Monitoramento-do-Ar-PI2/zefiro-electronics/README.md

# Zefiro electronics
This is the electronic team repository, here you can find the development of embedded system codes, eletronic schematics and pcb layouts.
