Monitoramento-do-Ar-PI2/zefiro-electronics/AnalogElectronics/README.md

<h1 align="center">
      Eletrônica Analógica Zéfiro
</h1>

<p align="justify">
      A eletrônica analógica é aplicada na estação de monitoramento de ar Zéfiro, sendo um sistema de instrumentação eletrônica modular, onde seus componentes são distríbuidos no melhor posicionamento para seu uso e as ligações realizadas, por meio de cabos, com a central de controle, utilizando o microcontrolador ESP32.
  
 <p align="center">
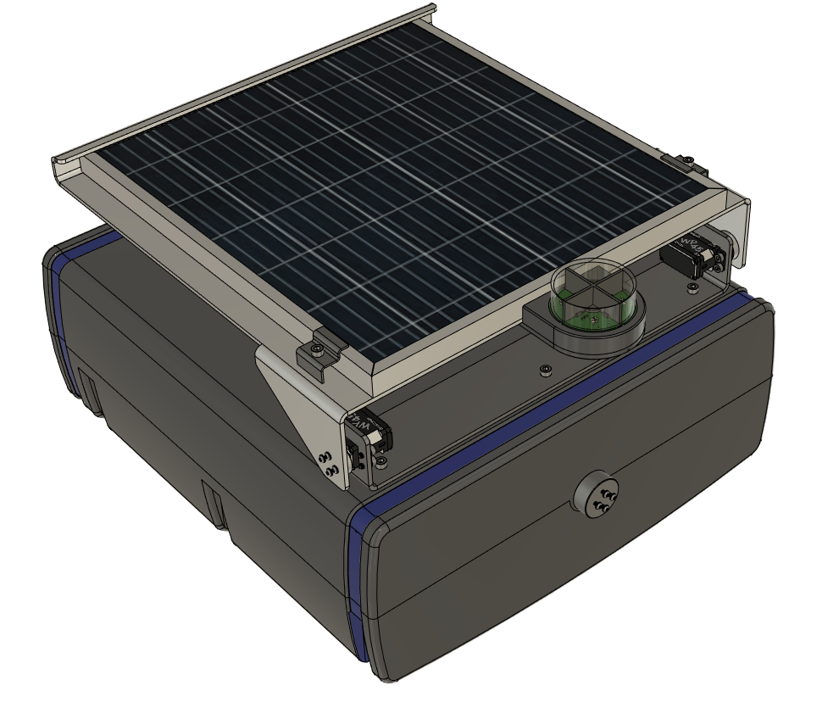
[picture p8: AnalogElectronics/RR_01.png]
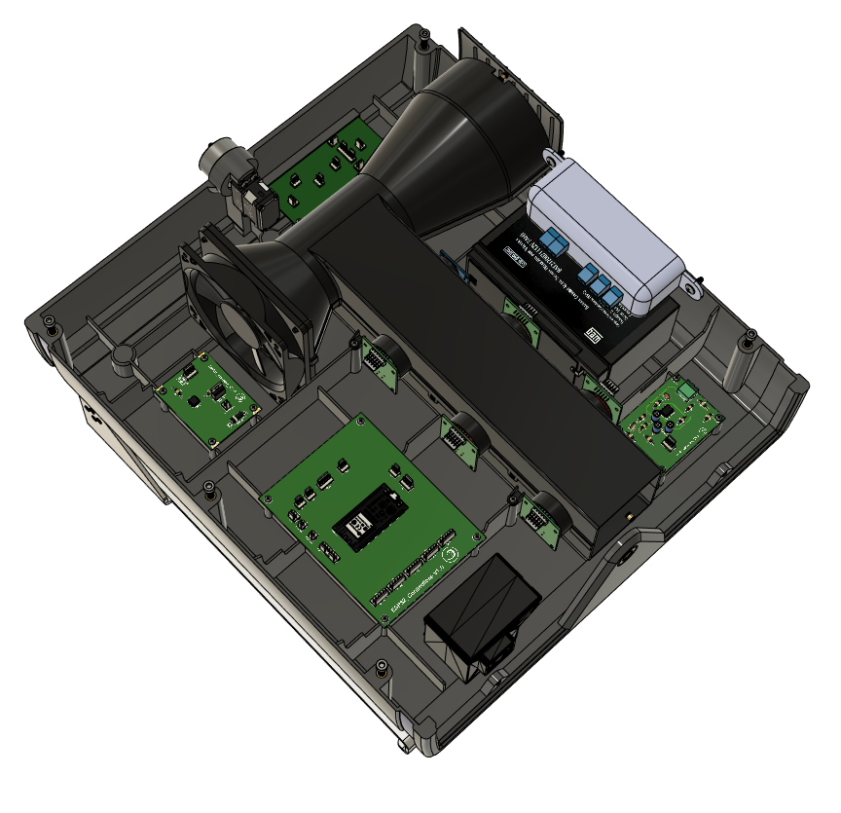
[picture p9: AnalogElectronics/RR_02.png]
        
</p>

 - **Esquemático Geral** O esquemático geral representa todos os módulos e suas conexões entre si, enquanto cada pasta tem o desenvolvimento individual do esqumático e layout de pcb destes módulos.

<p align="center">
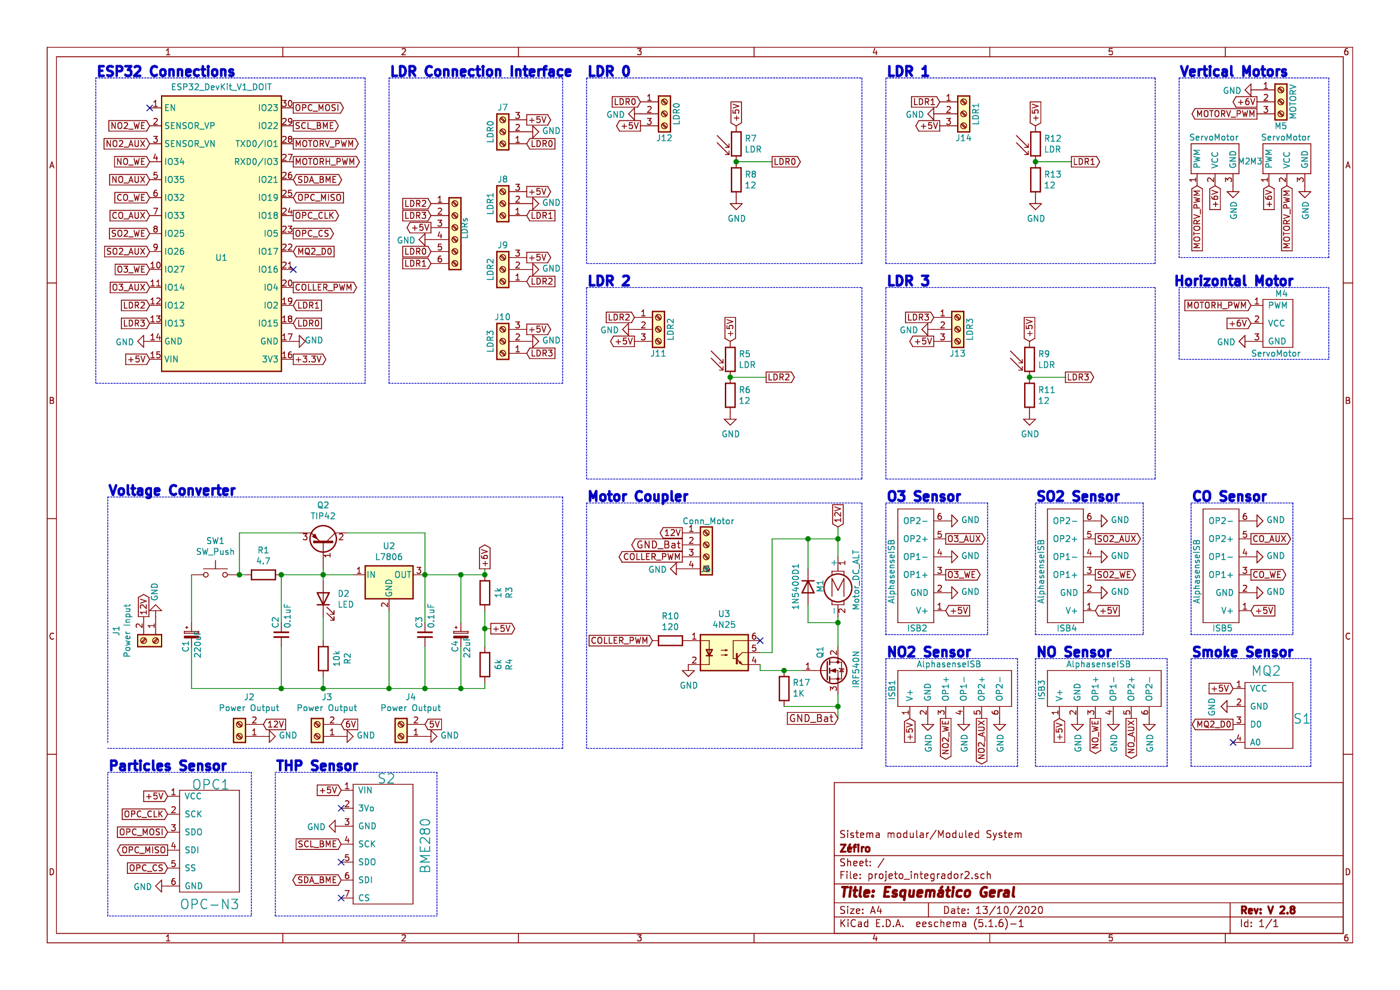
[picture p10: AnalogElectronics/esq_geral.png]
      
</p>

  #### Desenvolvedores:
  Clara Justa
  
  Débora Janini
  
  Felipe Alcântara
