Monitoramento-do-Ar-PI2/zefiro-electronics/EmbeddedSystem/README.md

<h1 align="center">
      Sistema Embarcado Zéfiro
</h1>

<p align="justify">
      O sistema embarcado do Zéfiro, tem como função o controle da estação autônoma e a transmissão dos dados coletados para o servidor. O sistema embarcado foi desenvolvido no modelo máquina de estados, abaixo é possível verificar o diagrama da máquina de estados desenvolvido.

 <p align="center">
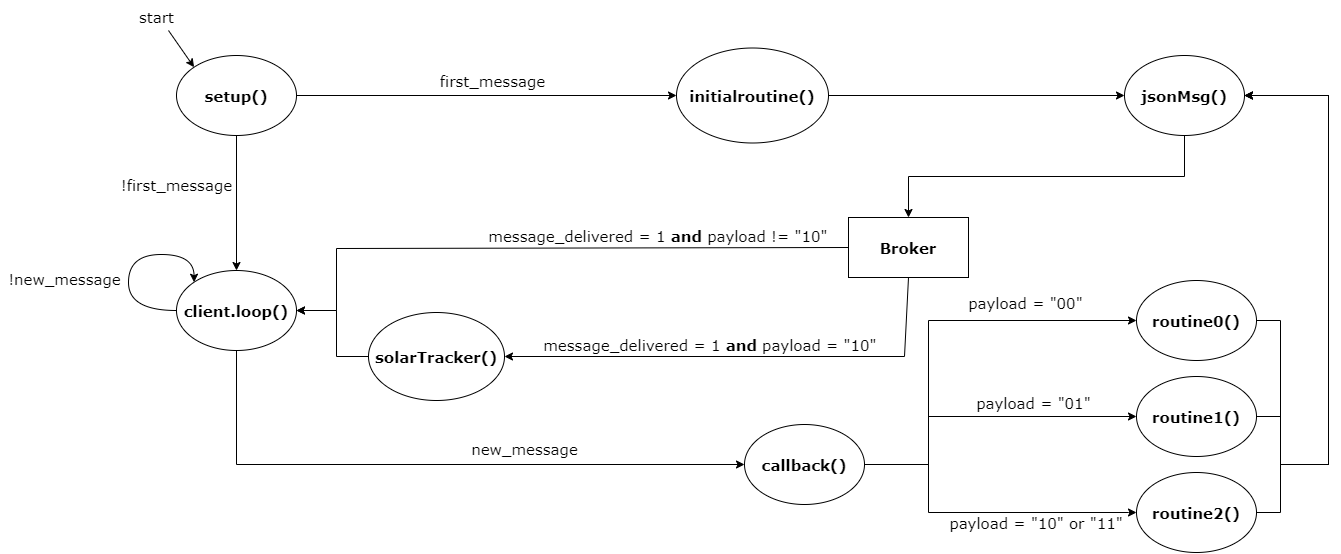
[picture p11: EmbeddedSystem/me_zefiro.png]
      
</p>      

Na pasta "Basics" é encotrado os códigos para teste dos subsistemas separados e a pasta "Integration" tem o desenvolvimento da integração do sistema no formato da imagem acima.
