Monitoramento-do-Ar-PI2/zefiro-electronics/EmbeddedSystem/Basics/README.md

## Desenvolvimento e teste de subsistemas
