Monitoramento-do-Ar-PI2/zefiro-electronics/AnalogElectronics/Dimensionamento_Solar.part2.pdf

1-Diagrama Unifilar

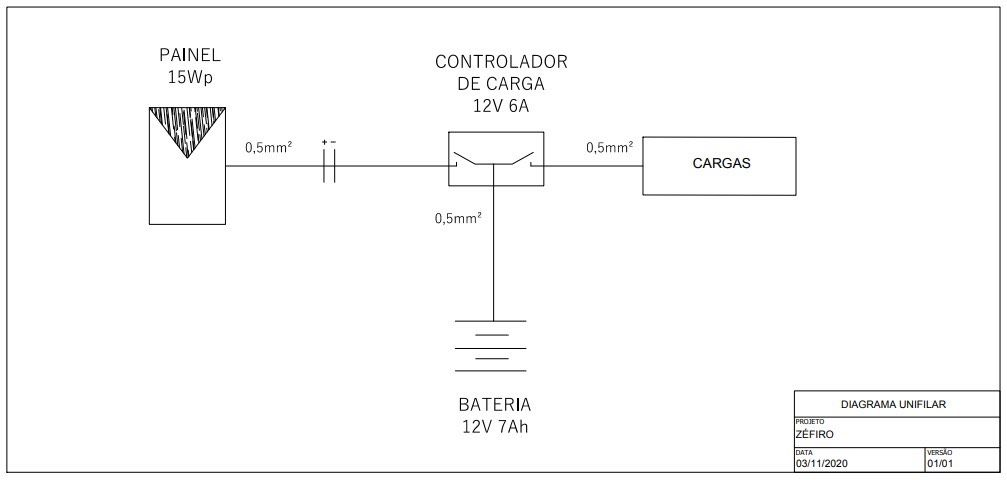
[picture p12: figure]

Figura: Diagrama Unifilar em AutoCad

2-Dimensionamento dos Fios
O dimensionamento dos cabos fotovoltaicos é realizado observando-se sempre critérios de Normas Brasileiras Regulamentadoras a respeito do funcionamento de placas fotovoltaicas. O primeiro cálculo realizado objetiva conhecer o valor da bitola do cabo e é definido da seguinte maneira:

S = N * Isc

S: Seção do cabo fotovoltaico N: Número de strings
Isc: Corrente de curto-circuito

S= 1 *0,93 = 0,93 A

Segundo a NBR 70 C (figura abaixo):

Fonte: ABNT

A seção do cabo escolhida é de S= 0,5mm².

Para finalizar os cálculos de dimensionamento dos cabos fotovoltaicos, necessita-se saber qual a queda de tensão máxima permitida aplicada à este projeto. Segundo a NBR 5410:

“Limites de queda de tensão fixados pela NBR 5410: 4% para as instalações alimentadas diretamente pela rede de distribuição pública de baixa tensão; e 7% para as instalações que contam com subestação própria ou com geração própria. Além disso, a queda de tensão máxima admissível nos circuitos terminais é de 4%.

Considerando a NBR acima, abaixo seguem os cálculos para descobrir a máxima queda de tensão permitida no presente projeto:

Vmp= Tensão máxima permitida = 17,5V
4% de 17,5V = 0,7V
Máxima tensão de queda permitida = 16,8V

3-SEGUIDOR SOLAR

Os seguidores solares são os únicos capazes de acompanhar o movimento do sol, a partir de um único ponto de referência ou a partir de dois pontos de referência. O seguidor solar de um eixo segue apenas o movimento do sol, enquanto o seguidor duplo se movimenta de leste para oeste e de norte a sul.
Medeiros (2016) descreve os tipos de rastreadores solar de dois eixos com ajuste de inclinação sendo:
- Rastreador de eixo vertical: eixo de norte-sul com o eixo do zênite, conhecido como rastreador de azimute do sol;
- Rastreador de eixo horizontal: orientado em paralelo à superfície da terra, pode ser orientado de leste-oeste ou norte-sul;
- Rastreador azimute-elevação: tem dois eixos de movimento, podendo gerar um melhor rendimento na captação de radiação solar, porém é necessário correção angular a partir do ângulo de azimute (Z) e o ângulo de elevação (H).

O sistema de dimensionamento do Zéfiro será feito com um rastreador azimute/elevação,figura 1, onde o sistema se movimenta a partir do eixo de rotação e translação, tendo o sol como referência , o fuso horário e dia no ano local(SANTOS,
C. A. S; SILVA, H. A. A; CARVALHO, J. L,2015).

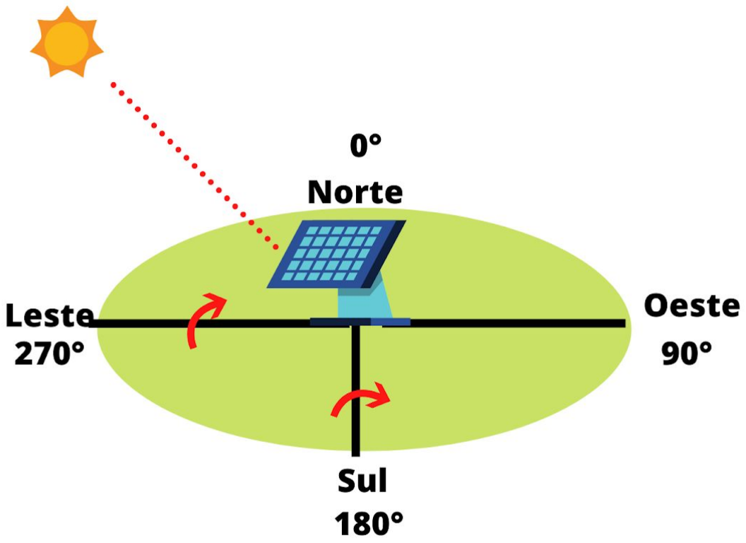
[picture p13: figure]

Figura 1: Modelo Rastreado Azimute-Elevação Fonte: Própria Autoria

A partir do Local Standard Time Meridian (LSTM) é feita a compensação do fuso local pela equação 1:
LSTM = 15ºΔT GMT

(1)

Onde, ΔT GM é a diferença entre o fuso horário local com relação ao fuso T horário do meridiano de Greenwich. Outro ponto que deve ser considerado é a trajetória do sol (EoT) que tem como finalidade corrigir a excentricidade da órbita terrestre.
EoT = 9, 37 sen(2B) − 7, 53 cos(B) − 1, 5 sen(B) (2)
B= | (d | 1) , d é o número de dias do ano; 365
360 | − 8

A partir da compensação do fuso local e a longitude do ambiente é possível obter o fator de correção,

TC = 4 ( Longitude − LSTM) + EoT (3)

O horário solar local (LST) é obtido a partir do horário local (LT) definido e do fator de correção

LST = LT + TC (4)
Para converter os dados obtidos em valor angular é necessário passar todos os dados em horário angular (HRA):
HRA = 15º (LST − 12) (5)

Com os dados em valor angular é possível obter o ângulo de declinação, que varia a cada estação do ano, ou seja, quando se inicia uma nova estação a incidência dos raios solares da Terra mudam, com isso nos período de equinócio o ângulo de declinação é considerado igual a 0º, enquanto para os períodos de solstício o ângulo deve ser calculado conforme a equação 6, onde d é o número de dias do ano e 23,45° é utilizado para os meses de solstícios que é de junho a dezembro.

δ = sen (sen(α)sen(( )(d 1)))

−1
365
360 | − 8 | (6)

Onde α = 0° ou 23, 45°
A partir do ângulo de elevação (H) é possível calcular a altura da placa solar, equação 7, e o azimute solar de rotação (Z),equação 8, ou seja, para cada hora do dia o azimute/elevação muda de acordo com os ângulos obtidos pela equação 7 e 8:
H = sen [senδsenφ | osδcosφcos(HRA)]
−1 | + c | (7)
Z = cos [(senδcosθ | osδsenθcos( HRA) ) ]
−1 | − c | (8)

Para analisar o comportamento da placa solar a partir das equações utilizadas que determinam seu grau de deslocamento, se escolheu o dia 22/10/2020 para, primeiramente realizar o cálculo de forma analítica,os resultados obtidos podem ser vistos na tabela 2.

Tabela 2- Resultados obtidos de forma analítico para o dia 22/10/2020

Fonte: Própria autoria

A partir da tabela 2 foi possível compreender o sistema de mecanismo de funcionamento de movimentação da placa solar para um dia, sendo assim se criou um modelo no excel, figura 2, para observar o comportamento da mudança do azimute/elevação para cada dia do ano, pois para cada dia do ano o ângulo de incidência muda, além do mais de janeiro a maio o ângulo α do ângulo de declinação é igual a 0°, enquanto de junho a dezembro o α é igual a 23,45°, interferindo na posição de elevação e de rotação dos eixos da placa solar.

HORÁRIO | AZIMUTE(Z) | ALTURA(H)
06h00 | 113° | 45°
07h00 | 115,21° | 56°
08h00 | 116° | 67°
09h00 | 117° | 68°
10h00 | 116° | 60°
11h00 | 113° | 48°
12h00 | 110° | 34°
13h00 | 106° | 20°
14h00 | 103° | 6°
15h00 | 99° | -7°
16h00 | 95° | -22°
17h00 | 91° | -37°
18h00 | 88° | -54°

Figura 2- Modelo Matemático das Equações de Azimute-Elevação em Excel para os 365 dias do ano

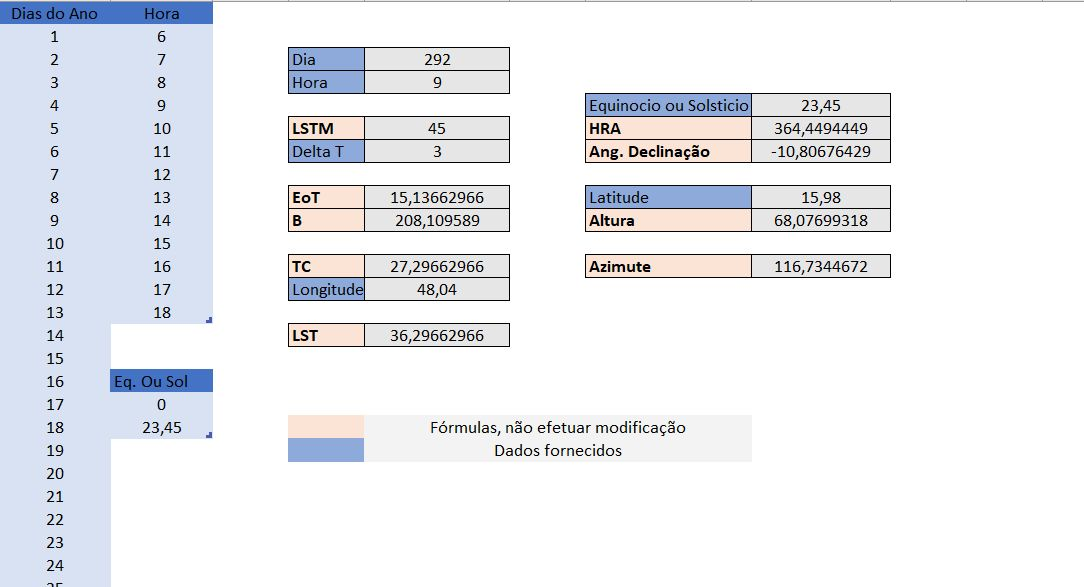
[picture p14: figure]

Fonte: Autoria Própria

4- Referência Bibliográfica
SANTOS, C. A. S; SILVA, H. A. A; CARVALHO, J. L. Desenvolvimento de um Mecanismo de Posicionamento de Placas Fotovoltaicas para Rastreamento Solar via Rasperry PI. Trabalho de Conclusão de Curso de Graduação de Curso 2, do curso de Engenharia Industrial Elétrica com ênfase em Automação da Universidade Tecnológica Federal do Paraná. Curitiba-PR,2015.

MEDEIROS, I. P. M. Sistema de Controle Rastreável para painéis fotovoltaicos: Protótipo. Universidade Federal do Rio Grande do Norte. Dissertação de mestrado. Programa de Pós-graduação em Engenharia Mecânica .Natal-RN,2016

ASSOCIAÇÃO BRASILEIRA DE NORMAS TÉCNICAS. NBR 5410: Instalações Elétricas de Baixa Tensão: Referências. Rio de Janeiro, p. 24. 2004

ASSOCIAÇÃO BRASILEIRA DE NORMAS TÉCNICAS. NBR 70c: Tabela de Condutores de Acordo com a Capacidade de Corrente Elétrica: Referências. Rio de Janeiro, p. 24. 2002
