Monitoramento-do-Ar-PI2/zefiro-electronics/AnalogElectronics/Calc_Painel.xlsx

Dias do Ano | Hora
1 | 6
2 | 7 | Dia | 292
3 | 8 | Hora | 9
4 | 9 |  |  | Equinocio ou Solsticio | 23.45
5 | 10 | LSTM | 45 | HRA | 364.4494449
6 | 11 | Delta T | 3 | Ang. Declinação | -10.80676429
7 | 12
8 | 13 | EoT | 15.13662966 | Latitude | 15.98
9 | 14 | B | 208.109589 | Altura | 68.07699318
10 | 15
11 | 16 | TC | 27.29662966 | Azimute | 116.7344672
12 | 17 | Longitude | 48.04
13 | 18
14 |  | LST | 36.29662966
15
16 | Eq. Ou Sol
17 | 0
18 | 23.45 |  | Fórmulas, não efetuar modificação
19 |  |  | Dados fornecidos
20
21
22
23
24
25
26
27
28
29
30
31
32
33
34
35
36
37
38
39
40
41
42
43
44
45
46
47
48
49
50
51
52
53
54
55
56
57
58
59
60
61
62
63
64
65
66
67
68
69
70
71
72
73
74
75
76
77
78
79
80
81
82
83
84
85
86
87
88
89
90
91
92
93
94
95
96
97
98
99
100
101
102
103
104
105
106
107
108
109
110
111
112
113
114
115
116
117
118
119
120
121
122
123
124
125
126
127
128
129
130
131
132
133
134
135
136
137
138
139
140
141
142
143
144
145
146
147
148
149
150
151
152
153
154
155
156
157
158
159
160
161
162
163
164
165
166
167
168
169
170
171
172
173
174
175
176
177
178
179
180
181
182
183
184
185
186
187
188
189
190
191
192
193
194
195
196
197
198
199
200
201
202
203
204
205
206
207
208
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
