Monitoramento-do-Ar-PI2/zefiro-electronics/AnalogElectronics/ESP32_Connections/ESP32_Connections.png

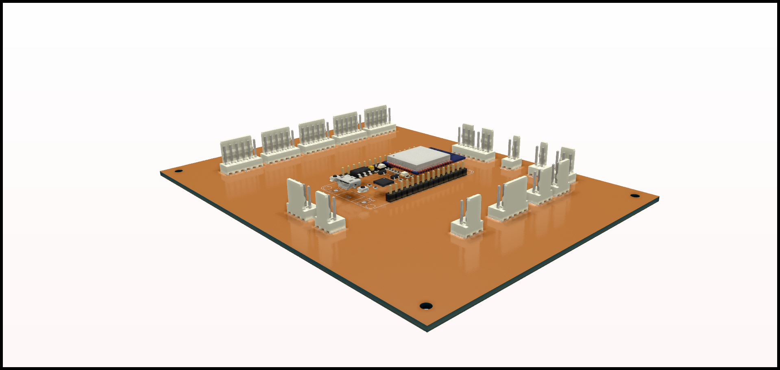
AnalogElectronics/ESP32_Connections/ESP32_Connections.png
