Monitoramento-do-Ar-PI2/zefiro-electronics/AnalogElectronics/ldr/ldr_placa.step

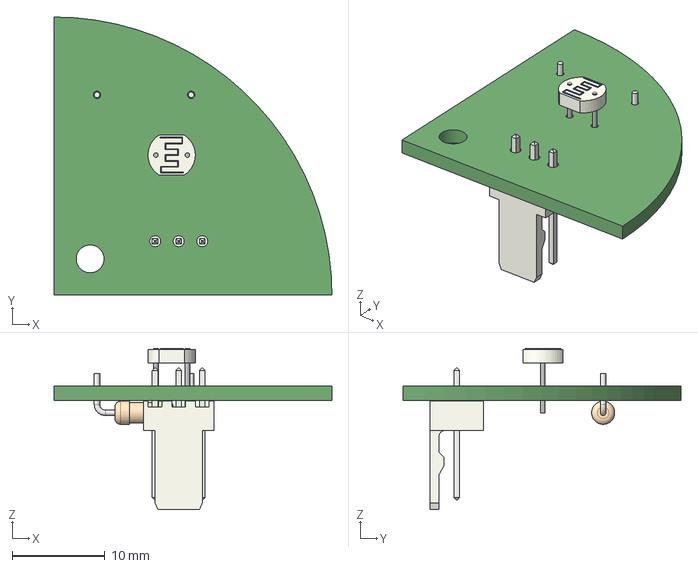
[picture p16: CAD file, 2020-12-04]
AnalogElectronics/ldr/ldr_placa.step
30.0 x 30.0 x 17.4 mm
