Monitoramento-do-Ar-PI2/zefiro-electronics/AnalogElectronics/motor_coupler/motor_coupler.step

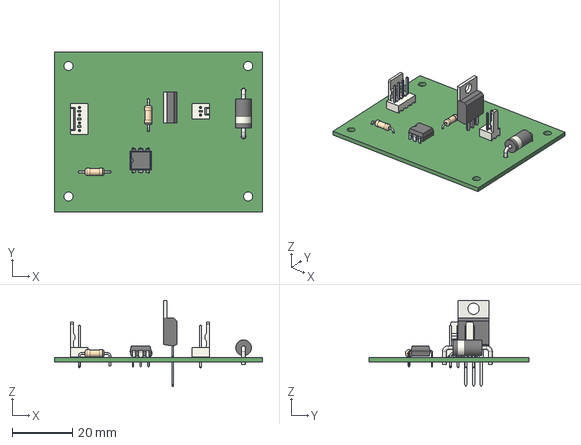
[picture p17: CAD file, 2020-12-04]
AnalogElectronics/motor_coupler/motor_coupler.step
68.8 x 52.8 x 28.5 mm
