Monitoramento-do-Ar-PI2/zefiro-electronics/AnalogElectronics/vertical_motors/vertical_motors.step

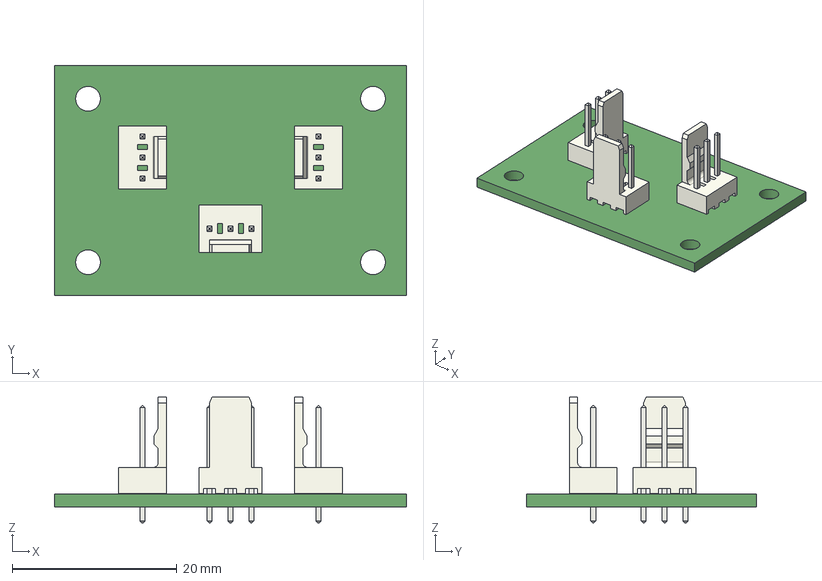
[picture p18: CAD file, 2020-12-04]
AnalogElectronics/vertical_motors/vertical_motors.step
42.7 x 27.9 x 15.3 mm
