Monitoramento-do-Ar-PI2/zefiro-electronics/AnalogElectronics/ESP32_Connections/layer_esp32.pdf

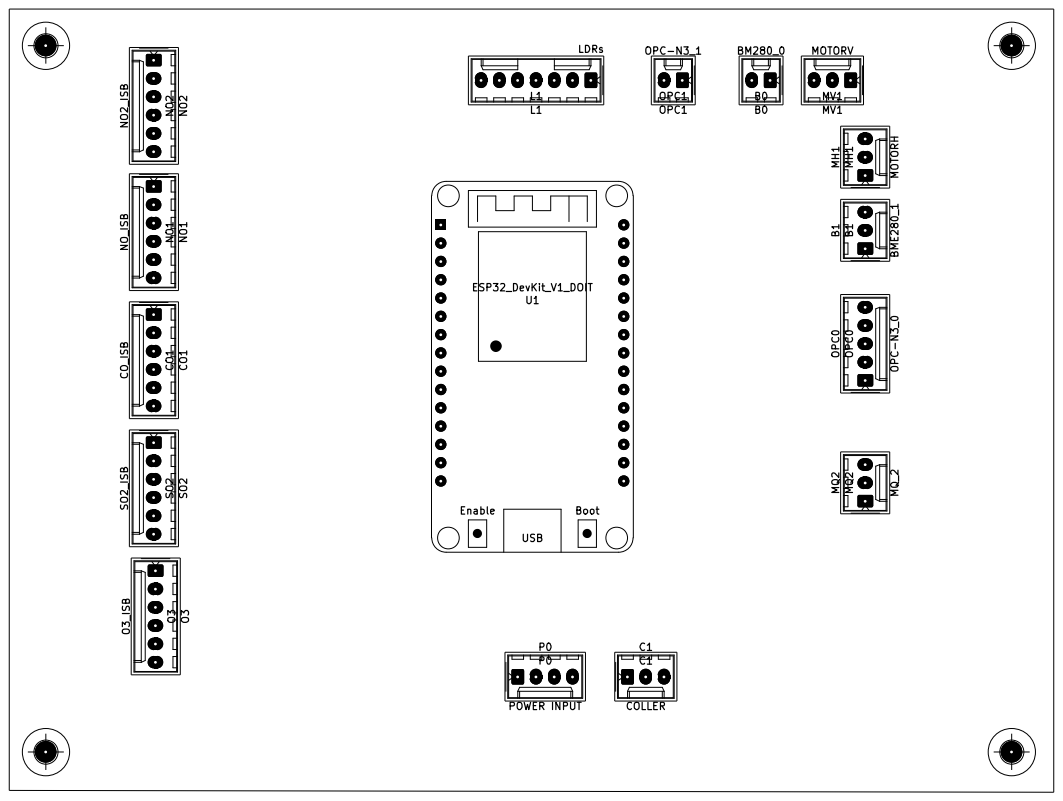
[picture p19: page 1]
