Monitoramento-do-Ar-PI2/zefiro-electronics/AnalogElectronics/ESP32_Connections/mask_esp32_connections.pdf

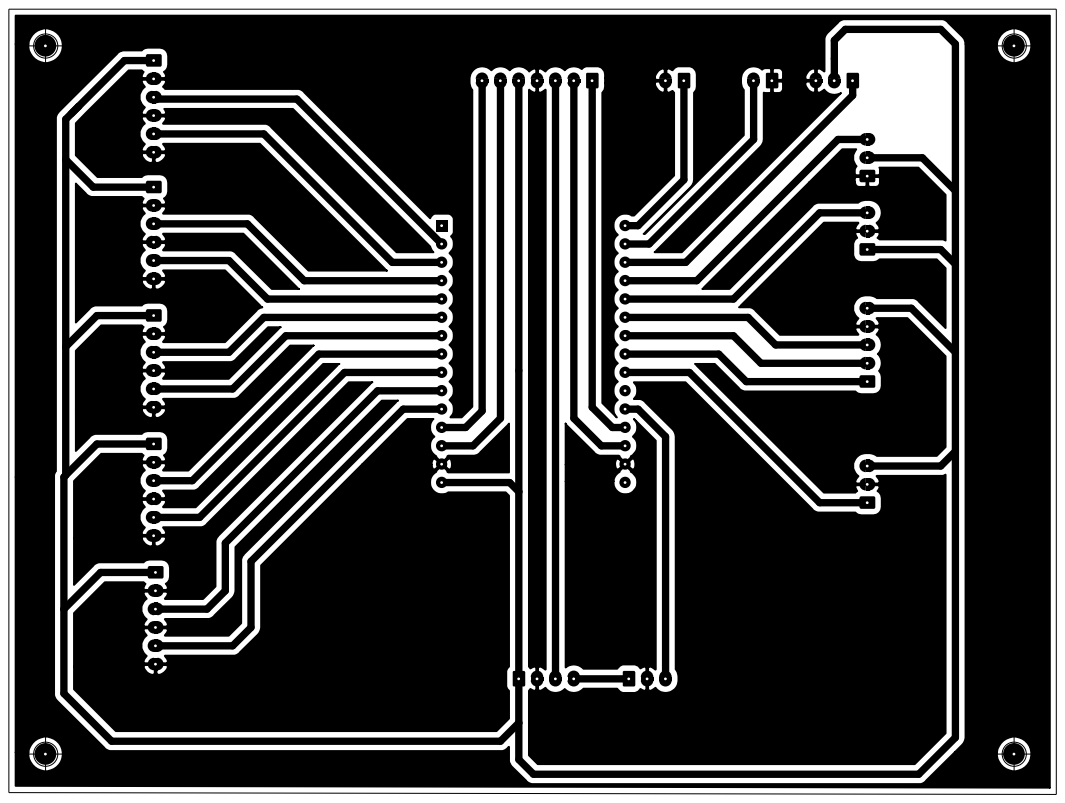
[picture p20: page 1]
