Monitoramento-do-Ar-PI2/zefiro-electronics/AnalogElectronics/ESP32_Connections/sch_esp32_connections.pdf

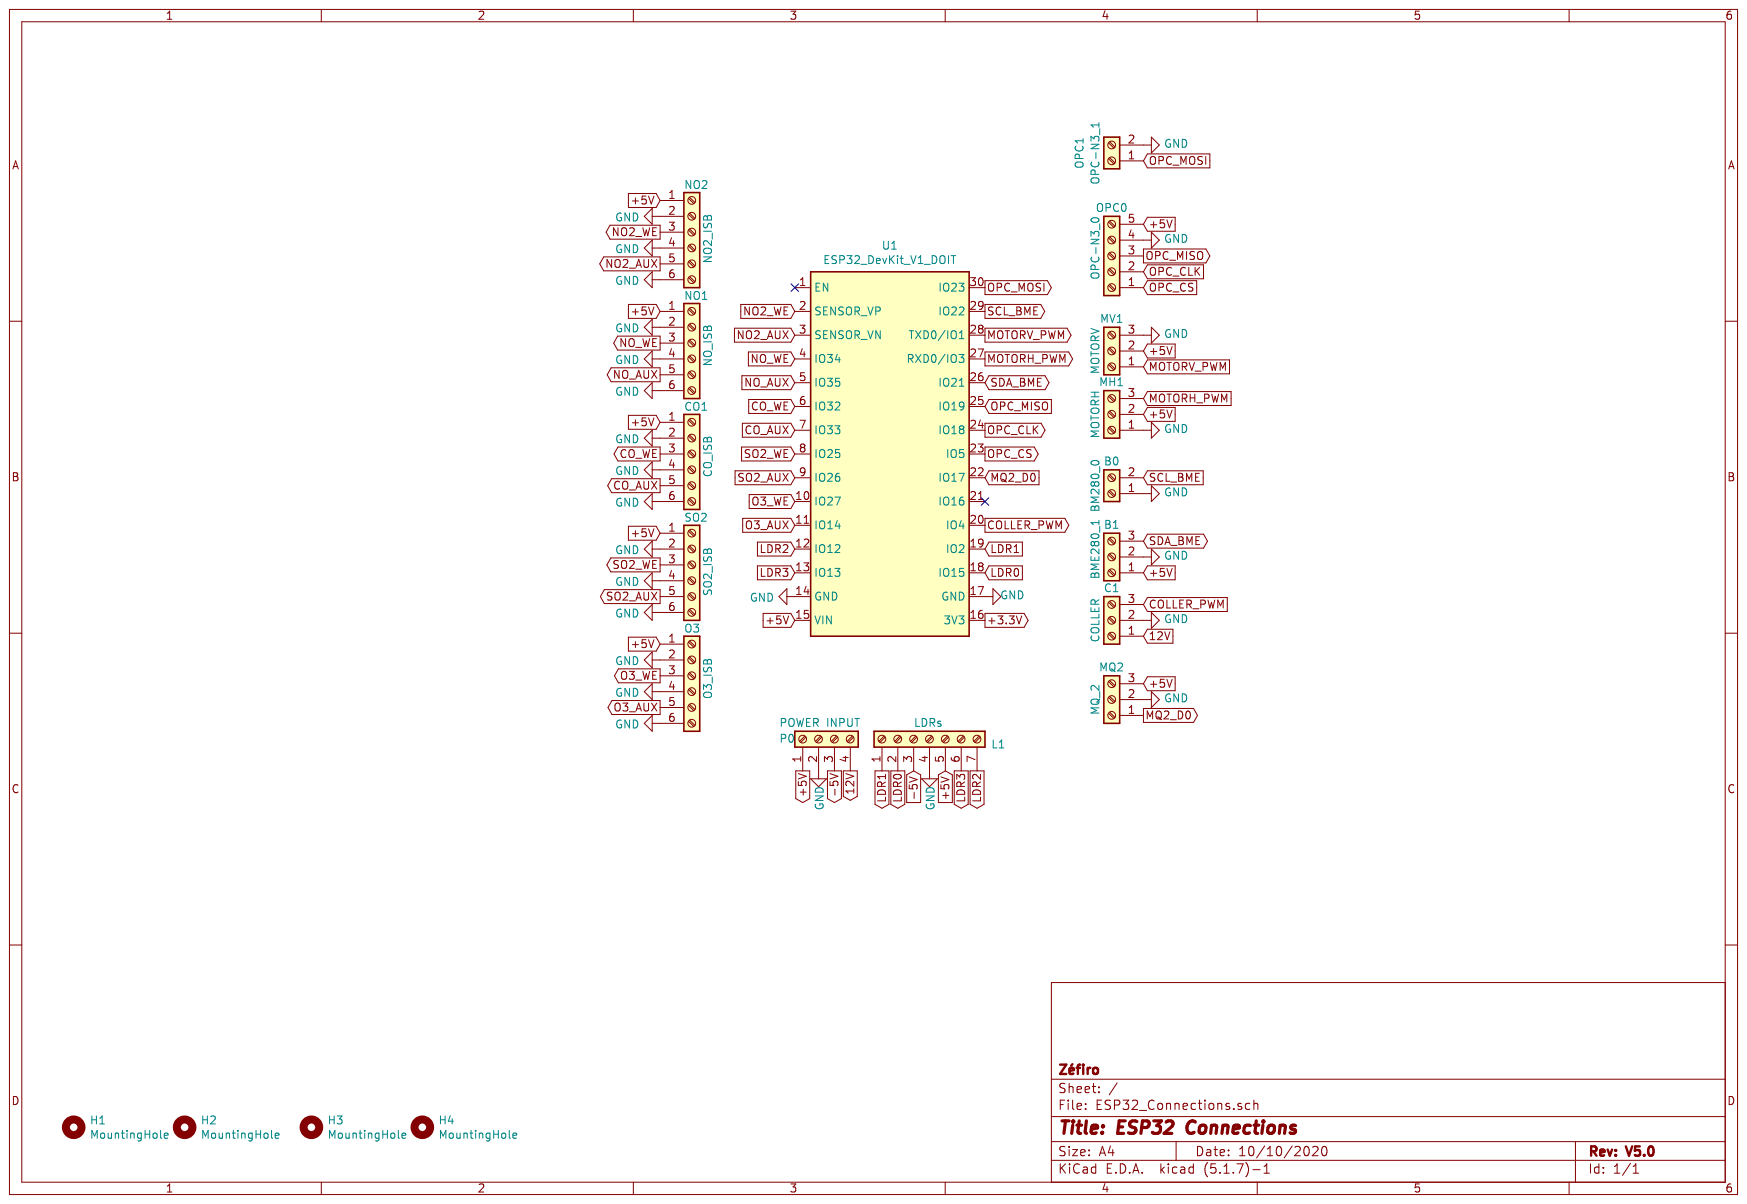
[picture p21: page 1]
