Monitoramento-do-Ar-PI2/zefiro-electronics/AnalogElectronics/vertical_motors/esq_v2.pdf

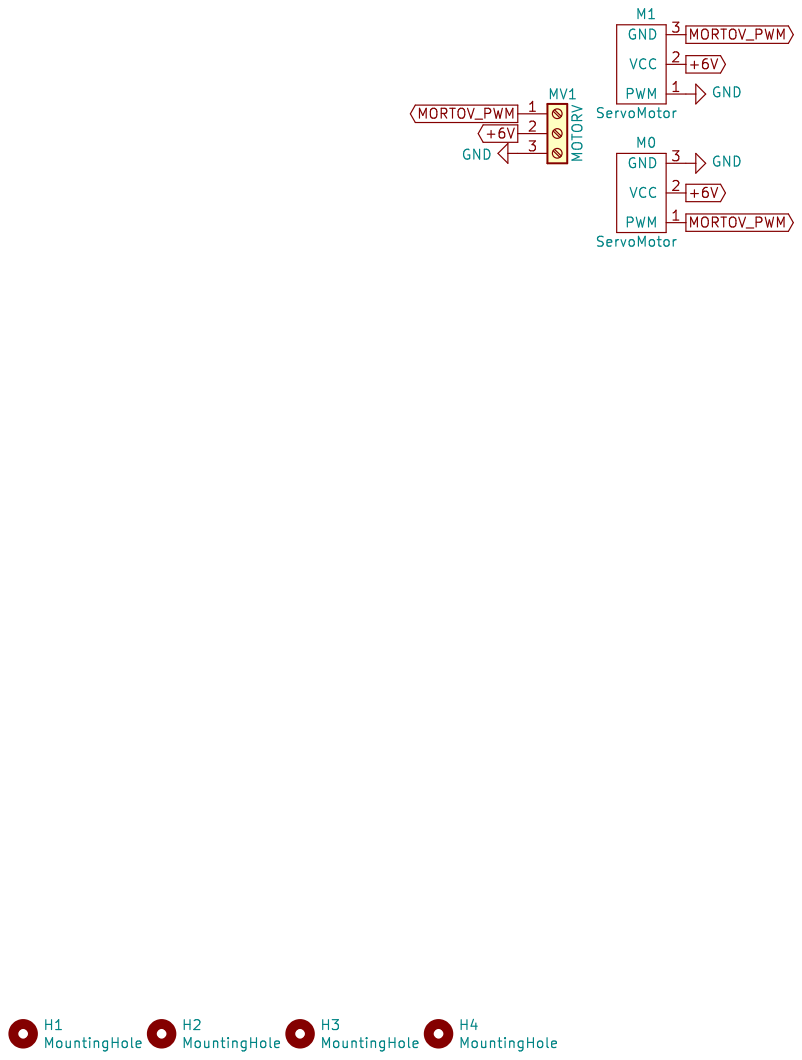
[picture p22: page 1]
