Monitoramento-do-Ar-PI2/zefiro-electronics/AnalogElectronics/vertical_motors/layer_vertical_motors.pdf

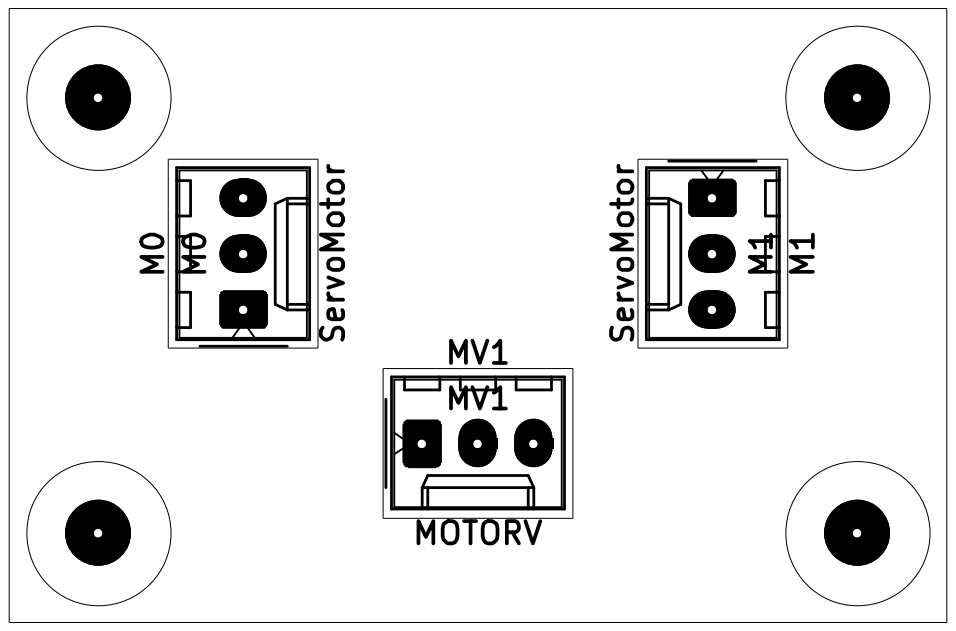
[picture p23: page 1]
