Monitoramento-do-Ar-PI2/zefiro-electronics/AnalogElectronics/vertical_motors/mask_vertical_motors.pdf

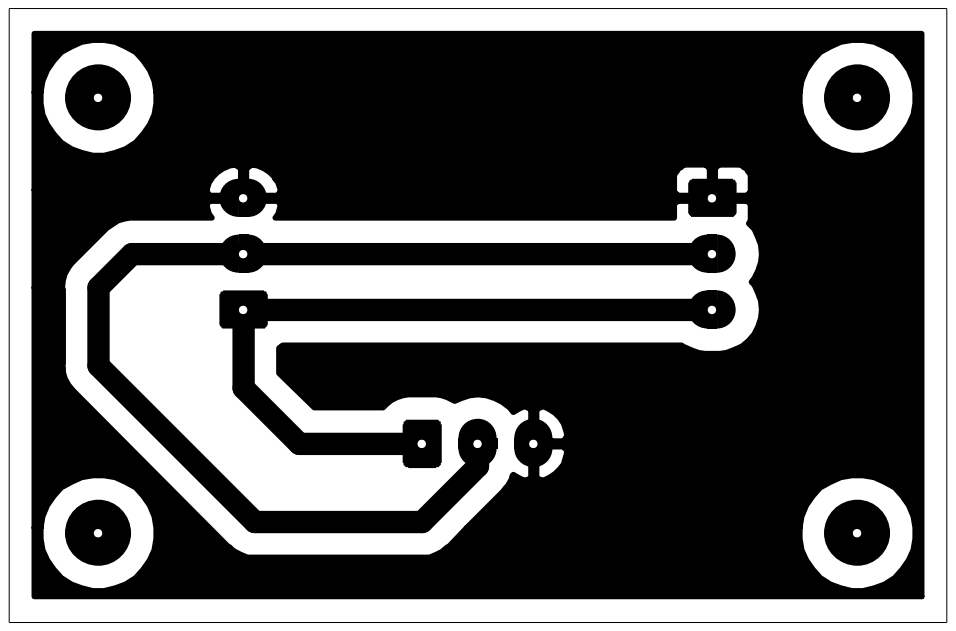
[picture p24: page 1]
