Monitoramento-do-Ar-PI2/zefiro-electronics/AnalogElectronics/ldr/layer_ldr_placa.pdf

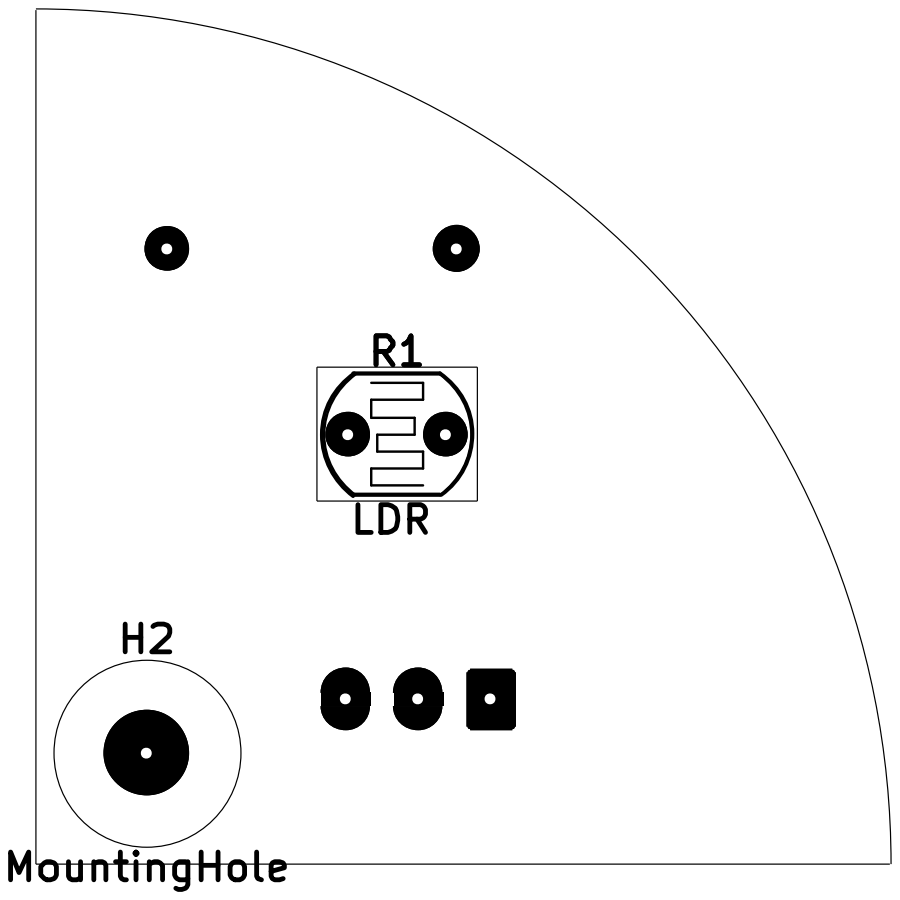
[picture p25: page 1]
