Monitoramento-do-Ar-PI2/zefiro-electronics/AnalogElectronics/ldr/maks_ldr_placa.pdf

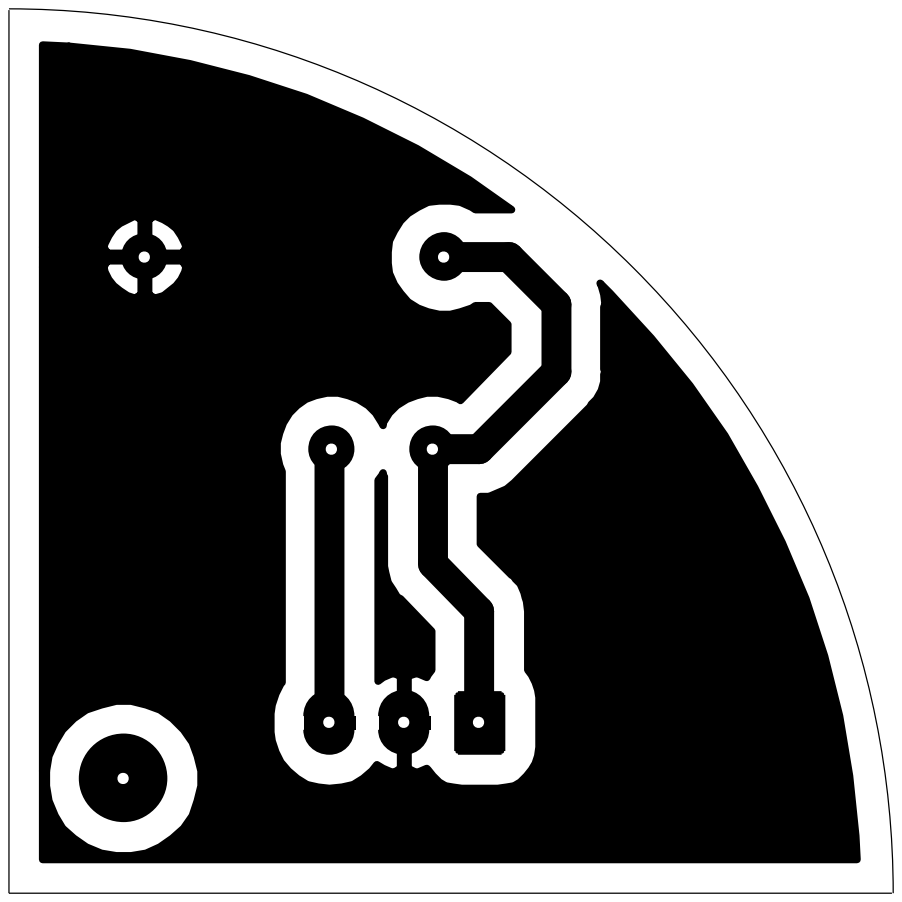
[picture p26: page 1]
