Monitoramento-do-Ar-PI2/zefiro-electronics/AnalogElectronics/ldr/mask_ldr.pdf

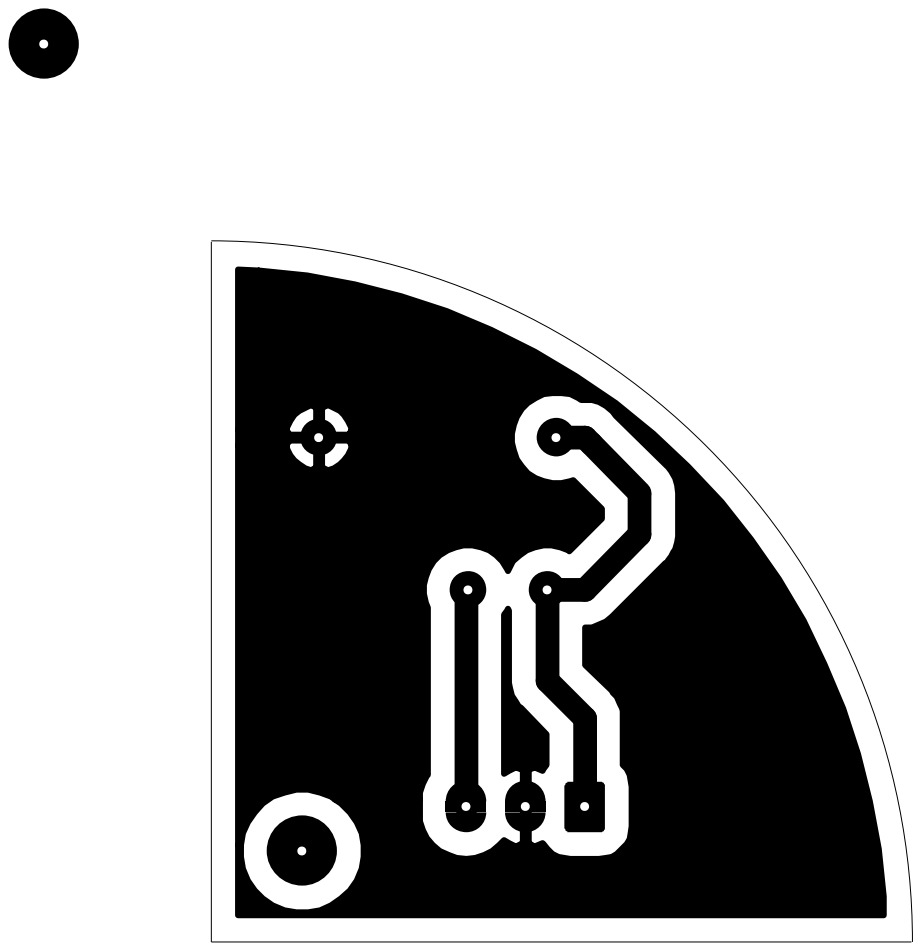
[picture p27: page 1]
