Monitoramento-do-Ar-PI2/zefiro-electronics/AnalogElectronics/motor_coupler/layer_moutor_coupler.pdf

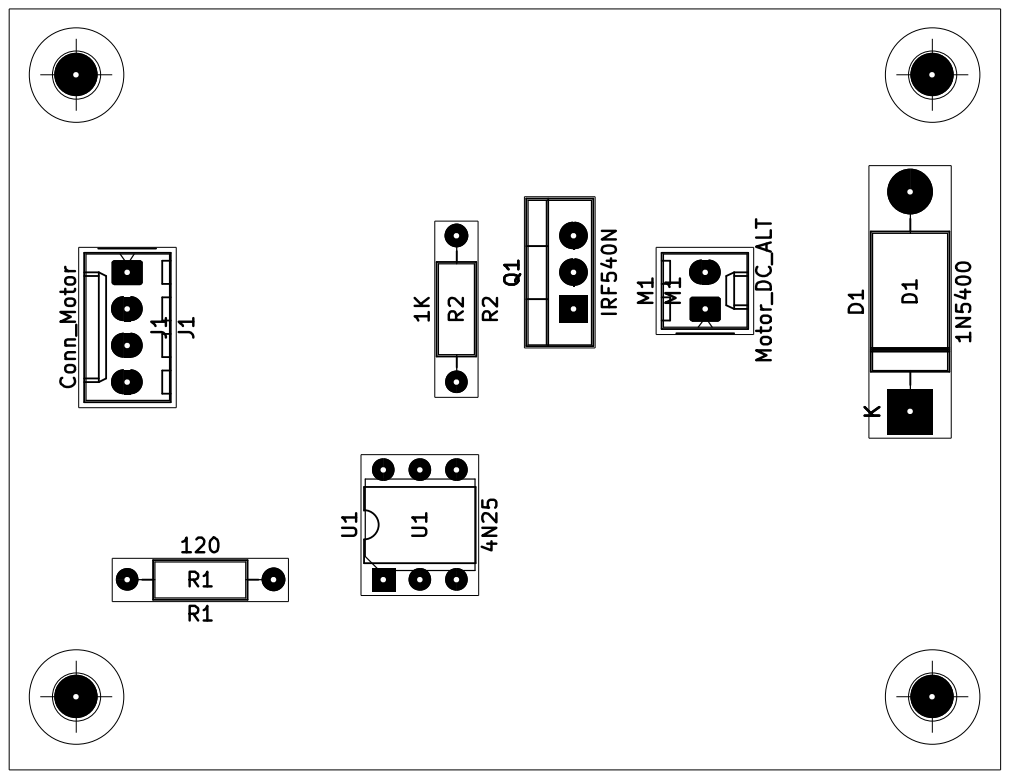
[picture p28: page 1]
