Monitoramento-do-Ar-PI2/zefiro-electronics/AnalogElectronics/motor_coupler/mask_motor_coupler.pdf

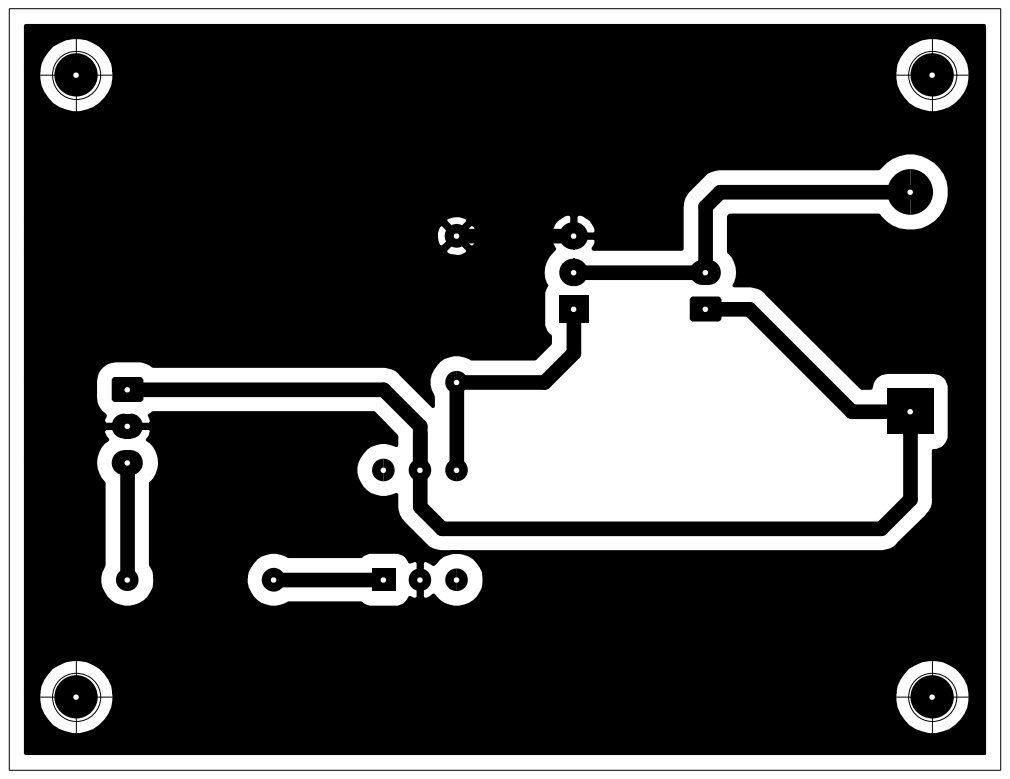
[picture p29: page 1]
