Monitoramento-do-Ar-PI2/zefiro-electronics/AnalogElectronics/motor_coupler/mask_moutor_coupler.pdf

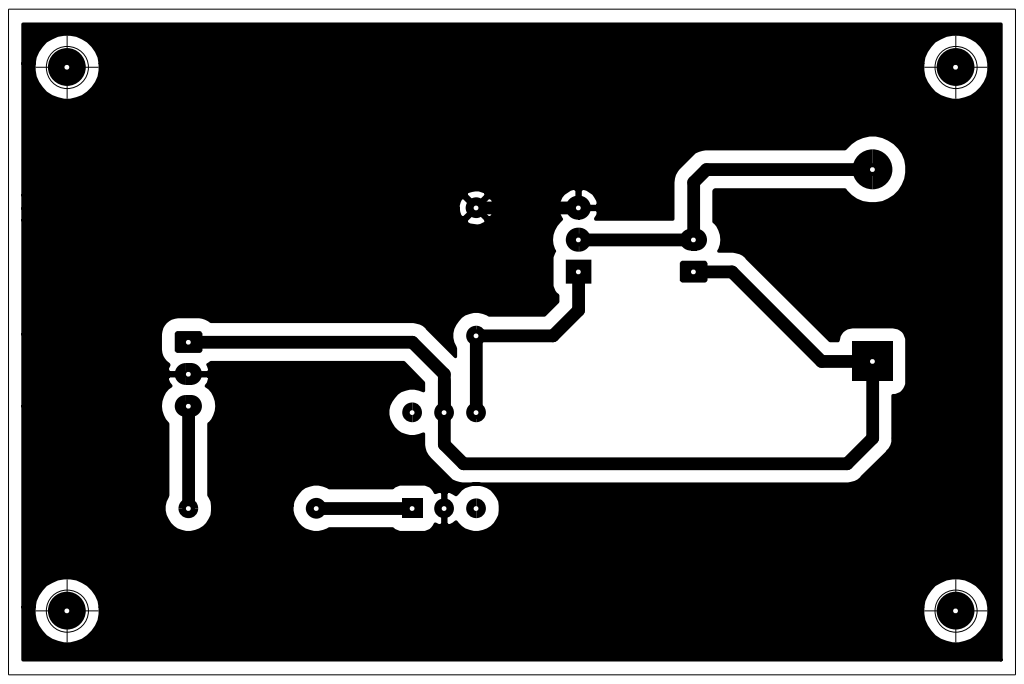
[picture p30: page 1]
