Monitoramento-do-Ar-PI2/zefiro-electronics/AnalogElectronics/motor_coupler/sch_motor_coupler.pdf

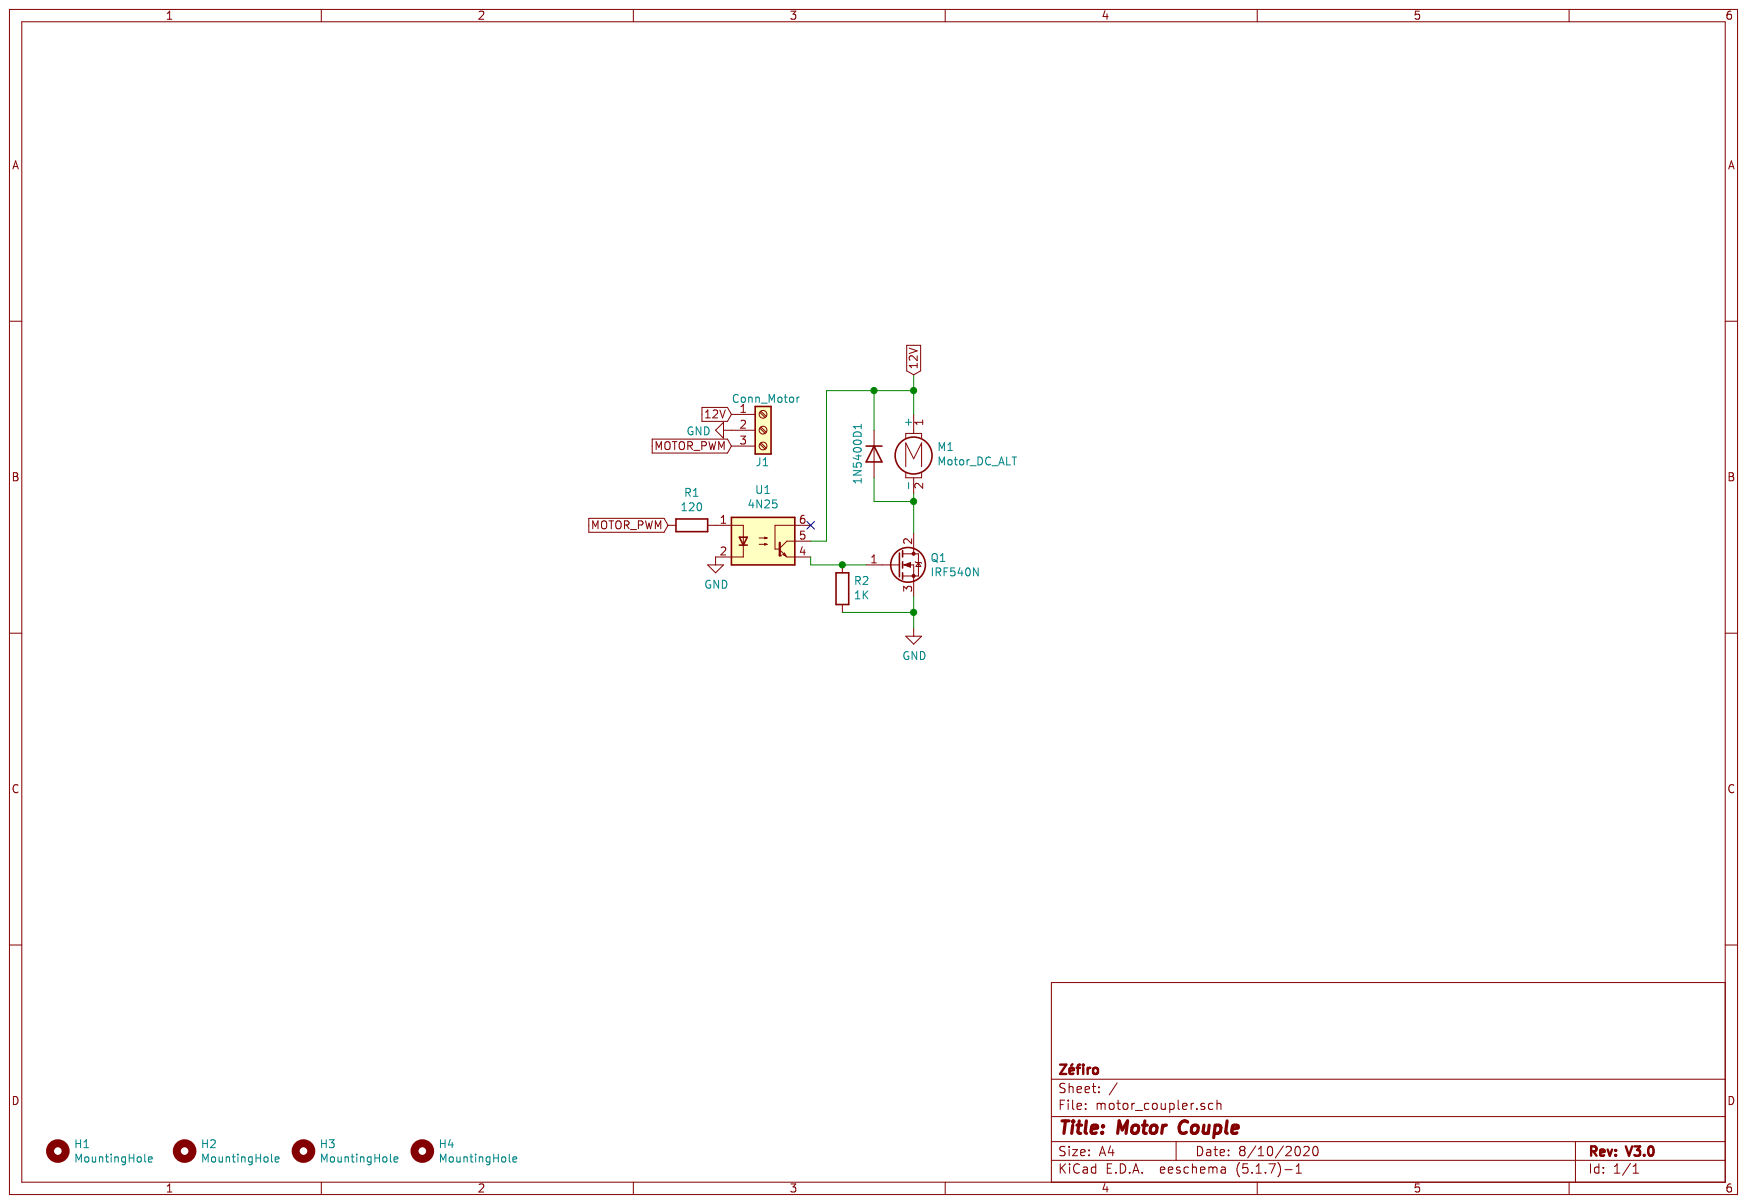
[picture p31: page 1]
