Monitoramento-do-Ar-PI2/zefiro-electronics/(list of files, drawings)

Other design files:
AnalogElectronics/Simulações/circ_LDR_simu..pdsprj
AnalogElectronics/Simulações/Voltage_Conv..pdsprj
