Monitoramento-do-Ar-PI2/zefiro-electronics/AnalogElectronics/ESP32_Connections/ESP32_Connections.kicad_pcb

## KiCad design AnalogElectronics/ESP32_Connections/ESP32_Connections.kicad_pcb (2020-12-04)

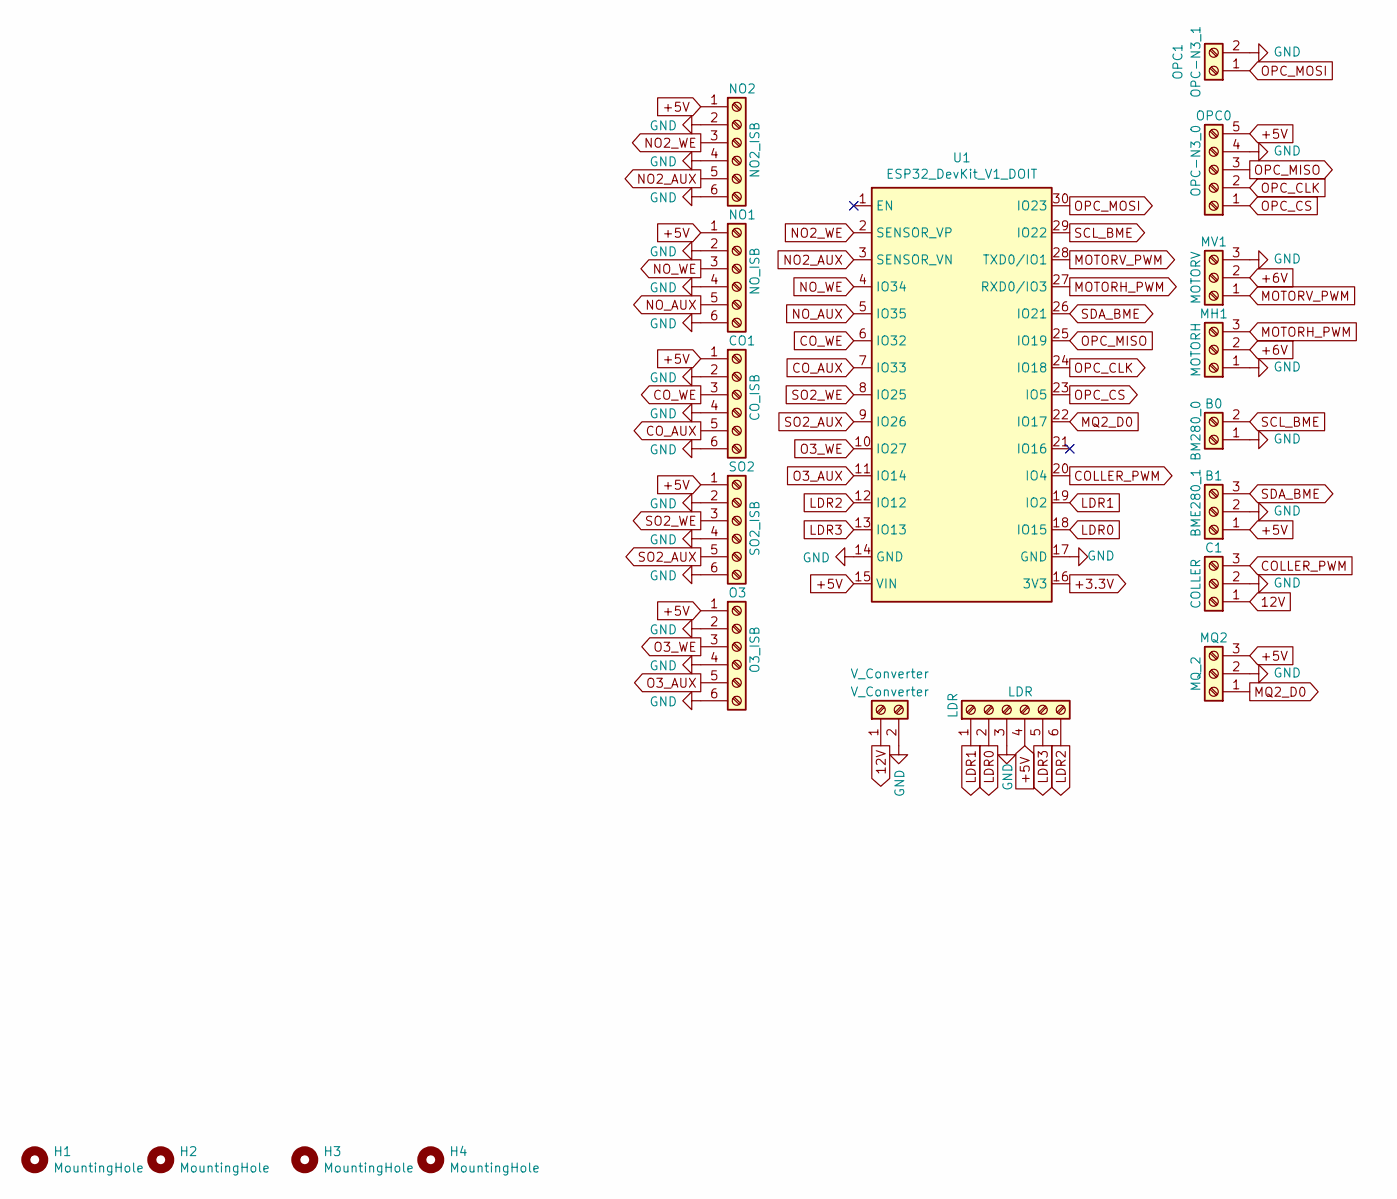
[picture p32: schematic ESP32_Connections.sch, ESP32 Connections]

Parts:
B0: BM280_0; Molex_KK-254_AE-6410-02A_1x02_P2.54mm_Vertical
B1: BME280_1; Molex_KK-254_AE-6410-03A_1x03_P2.54mm_Vertical
C1: COLLER; Molex_KK-254_AE-6410-03A_1x03_P2.54mm_Vertical
CO1: CO_ISB; Molex_KK-254_AE-6410-06A_1x06_P2.54mm_Vertical
H1, H2, H3, H4: MountingHole; MountingHole_3mm
LDR: LDR; Molex_KK-254_AE-6410-06A_1x06_P2.54mm_Vertical
MH1: MOTORH; Molex_KK-254_AE-6410-03A_1x03_P2.54mm_Vertical
MQ2: MQ_2; Molex_KK-254_AE-6410-03A_1x03_P2.54mm_Vertical
MV1: MOTORV; Molex_KK-254_AE-6410-03A_1x03_P2.54mm_Vertical
NO1: NO_ISB; Molex_KK-254_AE-6410-06A_1x06_P2.54mm_Vertical
NO2: NO2_ISB; Molex_KK-254_AE-6410-06A_1x06_P2.54mm_Vertical
O3: O3_ISB; Molex_KK-254_AE-6410-06A_1x06_P2.54mm_Vertical
OPC0: OPC-N3_0; Molex_KK-254_AE-6410-05A_1x05_P2.54mm_Vertical
OPC1: OPC-N3_1; Molex_KK-254_AE-6410-02A_1x02_P2.54mm_Vertical
SO2: SO2_ISB; Molex_KK-254_AE-6410-06A_1x06_P2.54mm_Vertical
U1: ESP32_DevKit_V1_DOIT; esp32_devkit_v1_doit
V_Converter: V_Converter; Molex_KK-254_AE-6410-02A_1x02_P2.54mm_Vertical

Connections:
12V: C1.1, V_Converter.1; also elsewhere on the board
+3.3V: U1.16 (3V3)
COLLER_PWM: C1.3, U1.20 (IO4)
CO_AUX: CO1.5, U1.7 (IO33)
CO_WE: CO1.3, U1.6 (IO32)
GND: B0.1, B1.2, C1.2, CO1.2, CO1.4, CO1.6, LDR.3, MH1.1, MQ2.2, MV1.3, NO1.2, NO1.4, NO1.6, NO2.2, NO2.4, NO2.6, O3.2, O3.4, O3.6, OPC0.4, OPC1.2, SO2.2, SO2.4, SO2.6, U1.14 (GND), U1.17 (GND), V_Converter.2; also elsewhere on the board
LDR0: LDR.2, U1.18 (IO15); also elsewhere on the board
LDR1: LDR.1, U1.19 (IO2); also elsewhere on the board
LDR2: LDR.6, U1.12 (IO12); also elsewhere on the board
LDR3: LDR.5, U1.13 (IO13); also elsewhere on the board
MOTORH_PWM: MH1.3, U1.27 (RXD0/IO3)
MOTORV_PWM: MV1.1, U1.28 (TXD0/IO1)
MQ2_D0: MQ2.1, U1.22 (IO17)
NO2_AUX: NO2.5, U1.3 (SENSOR_VN)
NO2_WE: NO2.3, U1.2 (SENSOR_VP)
NO_AUX: NO1.5, U1.5 (IO35)
NO_WE: NO1.3, U1.4 (IO34)
O3_AUX: O3.5, U1.11 (IO14)
O3_WE: O3.3, U1.10 (IO27)
OPC_CLK: OPC0.2, U1.24 (IO18)
OPC_CS: OPC0.1, U1.23 (IO5)
OPC_MISO: OPC0.3, U1.25 (IO19)
OPC_MOSI: OPC1.1, U1.30 (IO23)
SCL_BME: B0.2, U1.29 (IO22)
SDA_BME: B1.3, U1.26 (IO21)
SO2_AUX: SO2.5, U1.9 (IO26)
SO2_WE: SO2.3, U1.8 (IO25)

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
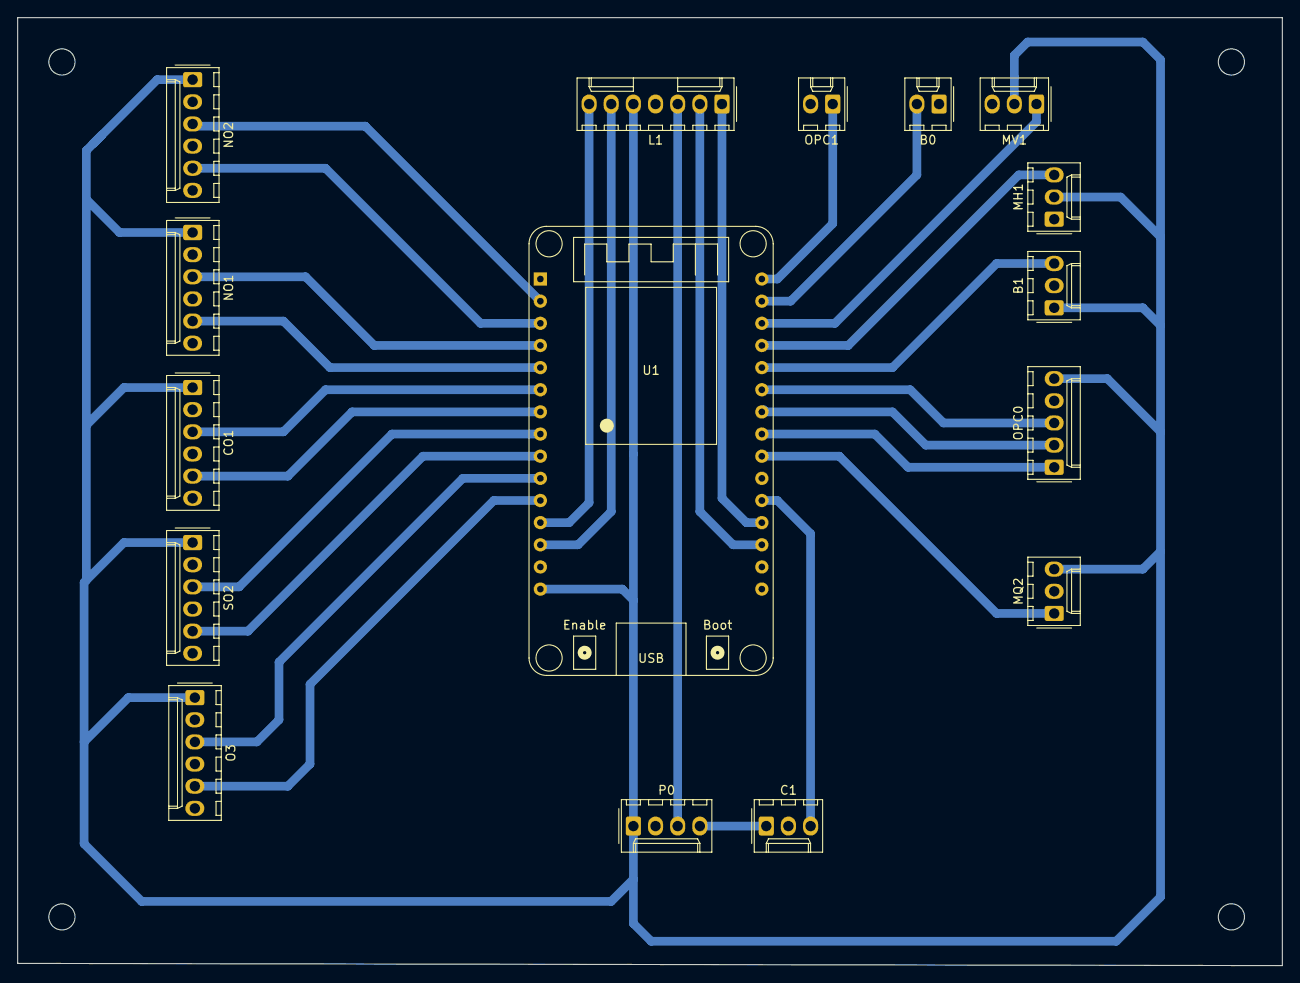
[picture p33: board ESP32_Connections.kicad_pcb from above]

Board: 2 copper layers, 145.0 x 108.7 mm, 20 parts (0 on the bottom side), 28 nets.

Other parts of the board:
L1: LDRs; Molex_KK-254_AE-6410-07A_1x07_P2.54mm_Vertical
P0: POWER INPUT; Molex_KK-254_AE-6410-04A_1x04_P2.54mm_Vertical

Their connections:
12V: P0.4; also elsewhere on the board
-5V: L1.3, P0.3
GND: L1.4, P0.2; also elsewhere on the board
LDR0: L1.2; also elsewhere on the board
LDR1: L1.1; also elsewhere on the board
LDR2: L1.7; also elsewhere on the board
LDR3: L1.6; also elsewhere on the board
