Monitoramento-do-Ar-PI2/zefiro-electronics/AnalogElectronics/vertical_motors/vertical_motors.kicad_pcb

## KiCad design AnalogElectronics/vertical_motors/vertical_motors.kicad_pcb (2020-12-04)

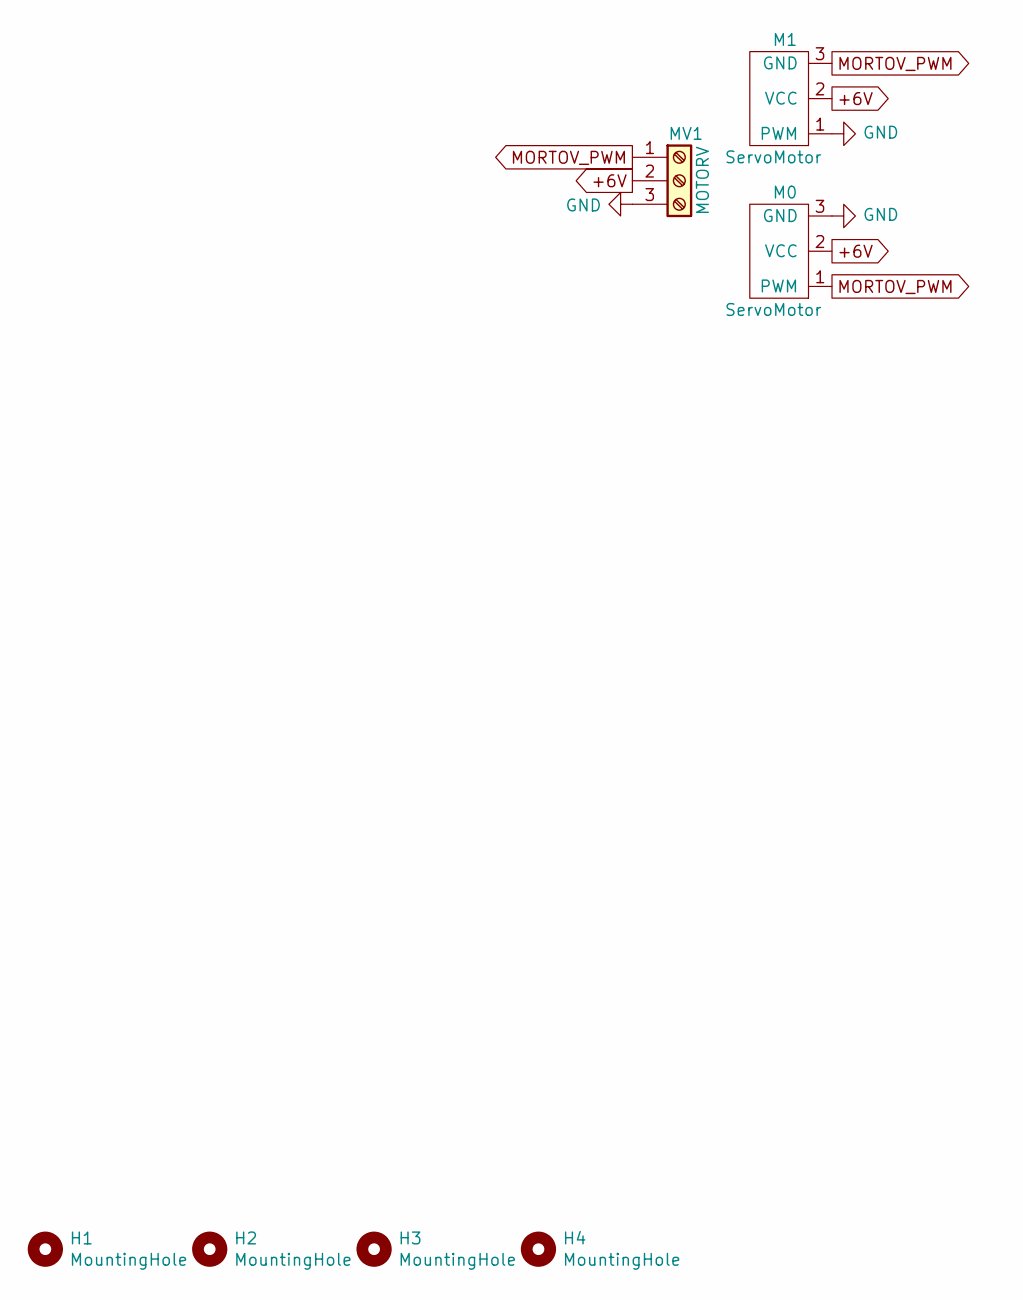
[picture p34: schematic vertical_motors.sch]

Parts:
H1, H2, H3, H4: MountingHole; MountingHole_3mm
M0, M1: ServoMotor; Molex_KK-254_AE-6410-03A_1x03_P2.54mm_Vertical
MV1: MOTORV; Molex_KK-254_AE-6410-03A_1x03_P2.54mm_Vertical

Connections:
+5V: M0.2 (VCC), M1.2 (VCC), MV1.2
GND: M0.3 (GND), M1.1 (PWM), MV1.3
MORTOV_PWM: M0.1 (PWM), M1.3 (GND), MV1.1

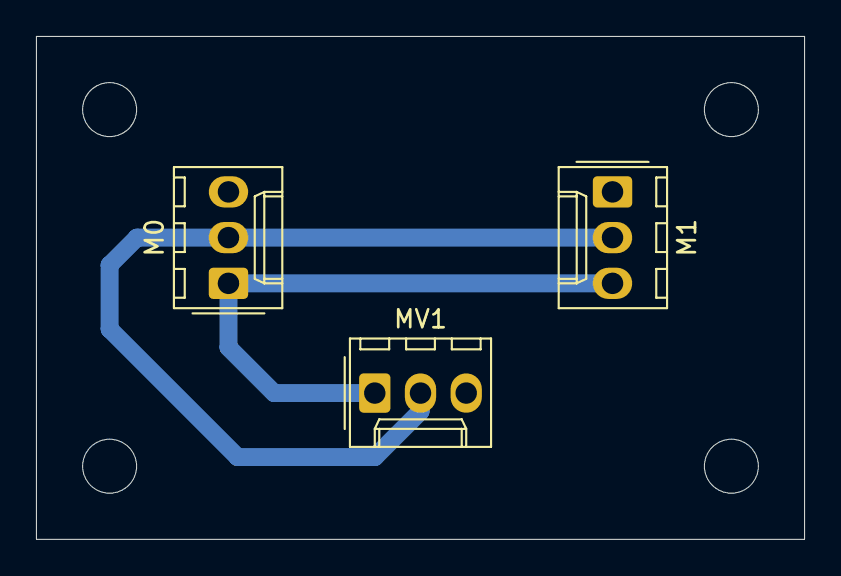
[picture p35: board vertical_motors.kicad_pcb from above]

Board: 2 copper layers, 42.7 x 27.9 mm, 7 parts (0 on the bottom side), 3 nets.
