Monitoramento-do-Ar-PI2/zefiro-electronics/AnalogElectronics/ldr/ldr_coon.kicad_pcb

## KiCad design AnalogElectronics/ldr/ldr_coon.kicad_pcb (2020-12-04)

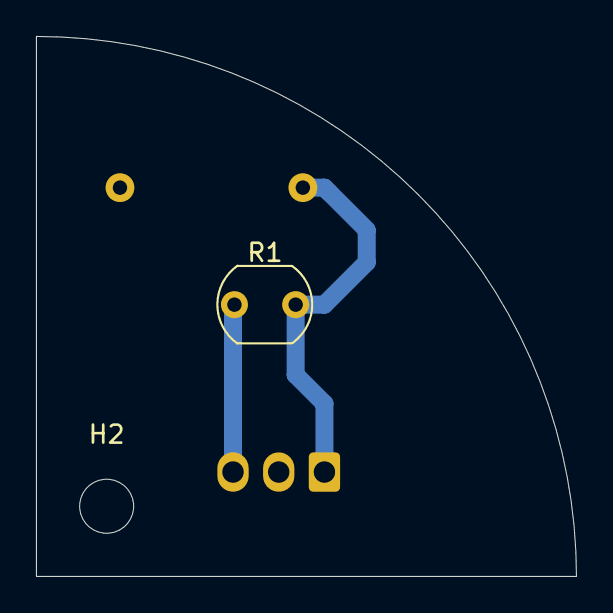
[picture p36: board ldr_coon.kicad_pcb from above]

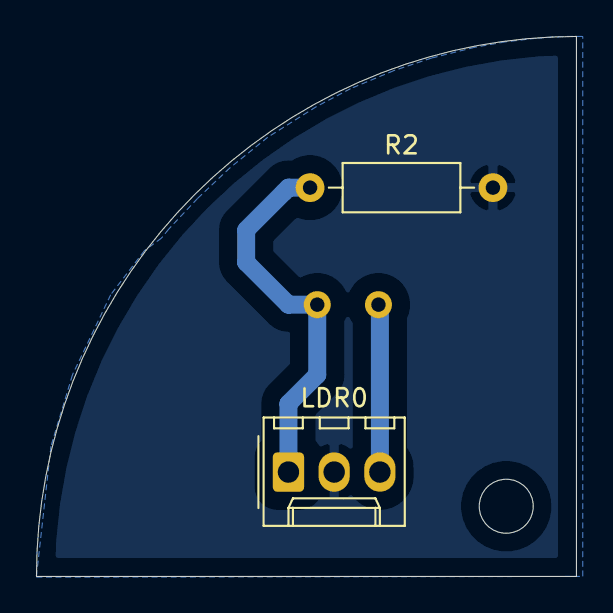
[picture p37: board ldr_coon.kicad_pcb from below]

Board: 2 copper layers, 30.0 x 30.0 mm, 4 parts (2 on the bottom side), 3 nets.

Parts:
H2: MountingHole; MountingHole_3mm
LDR0: LDR0; Molex_KK-254_AE-6410-03A_1x03_P2.54mm_Vertical
R1: LDR; R_LDR_5.1x4.3mm_P3.4mm_Vertical
R2: 1k; R_Axial_DIN0207_L6.3mm_D2.5mm_P10.16mm_Horizontal

Connections:
+5V: LDR0.3, R1.1
GND: LDR0.2, R2.2
LDR0: LDR0.1, R1.2, R2.1
