Monitoramento-do-Ar-PI2/zefiro-electronics/AnalogElectronics/Conversor_Tensao/Simetrica_v2.kicad_pcb

## KiCad design AnalogElectronics/Conversor_Tensao/Simetrica_v2.kicad_pcb (2020-12-04)

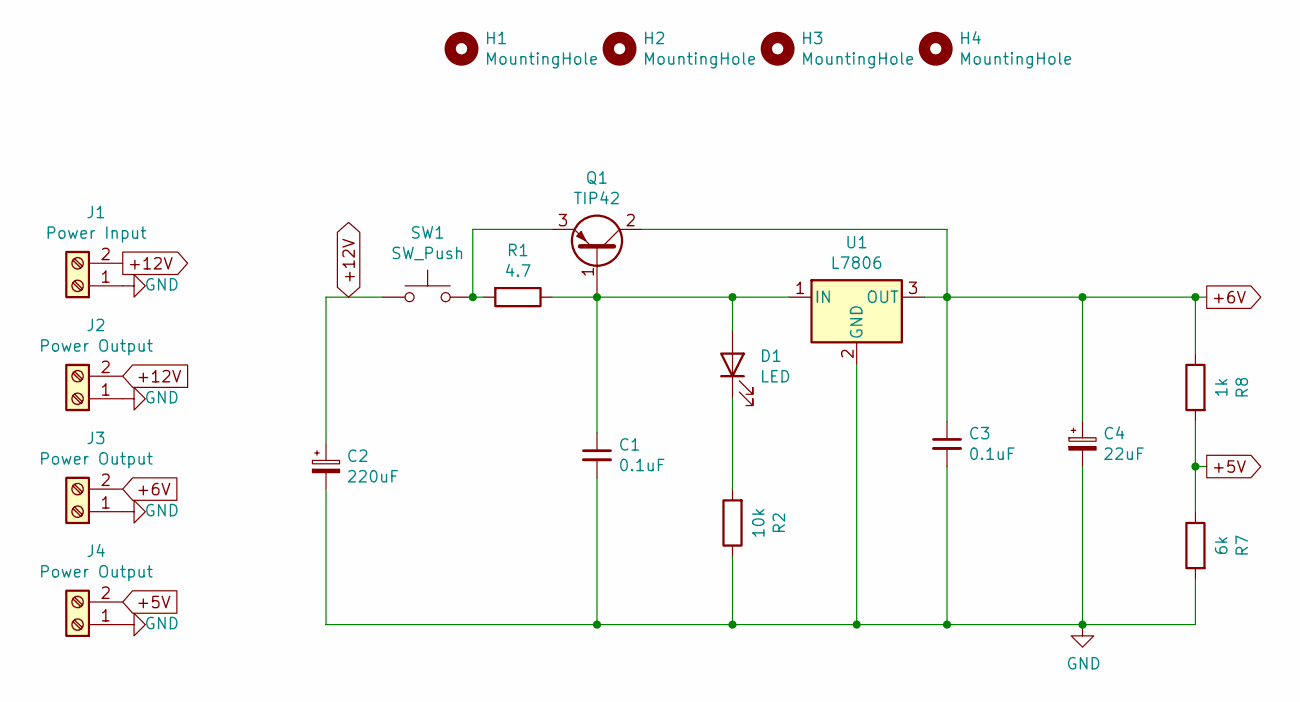
[picture p38: schematic Simetrica_v2.sch]

Parts:
C1, C3: 0.1uF; C_Disc_D6.0mm_W2.5mm_P5.00mm
C2: 220uF; C_Radial_D6.3mm_H11.0mm_P2.50mm
C4: 22uF; C_Radial_D6.3mm_H11.0mm_P2.50mm
D1: LED; LED_D3.0mm
H1, H2, H3, H4: MountingHole; MountingHole_2mm
J1: Power Input; PhoenixContact_MSTBA_2,5_2-G-5,08_1x02_P5.08mm_Horizontal
J2, J3, J4: Power Output; Molex_KK-254_AE-6410-02A_1x02_P2.54mm_Vertical
Q1: TIP42; TO-220-3_Vertical
R1: 4.7; R_Axial_DIN0207_L6.3mm_D2.5mm_P10.16mm_Horizontal
R2: 10k; R_Axial_DIN0207_L6.3mm_D2.5mm_P10.16mm_Horizontal
R7: 6k; R_Axial_DIN0207_L6.3mm_D2.5mm_P10.16mm_Horizontal
R8: 1k; R_Axial_DIN0207_L6.3mm_D2.5mm_P10.16mm_Horizontal
SW1: SW_Push; SW_DIP_SPSTx01_Slide_9.78x4.72mm_W7.62mm_P2.54mm
U1: L7806; TO-220-3_Vertical

Connections:
+5V: J4.2, R7.1, R8.2
+6V: C3.1, C4.1, J3.2, Q1.2 (C), R8.1, U1.3 (OUT)
+12V: C2.1, J1.2, J2.2, SW1.1
GND: C1.2, C2.2, C3.2, C4.2, J1.1, J2.1, J3.1, J4.1, R2.1, R7.2, U1.2 (GND)
unnamed: C1.1, D1.2 (A), Q1.1 (B), R1.1, U1.1 (IN)
unnamed: D1.1 (K), R2.2
unnamed: Q1.3 (E), R1.2, SW1.2

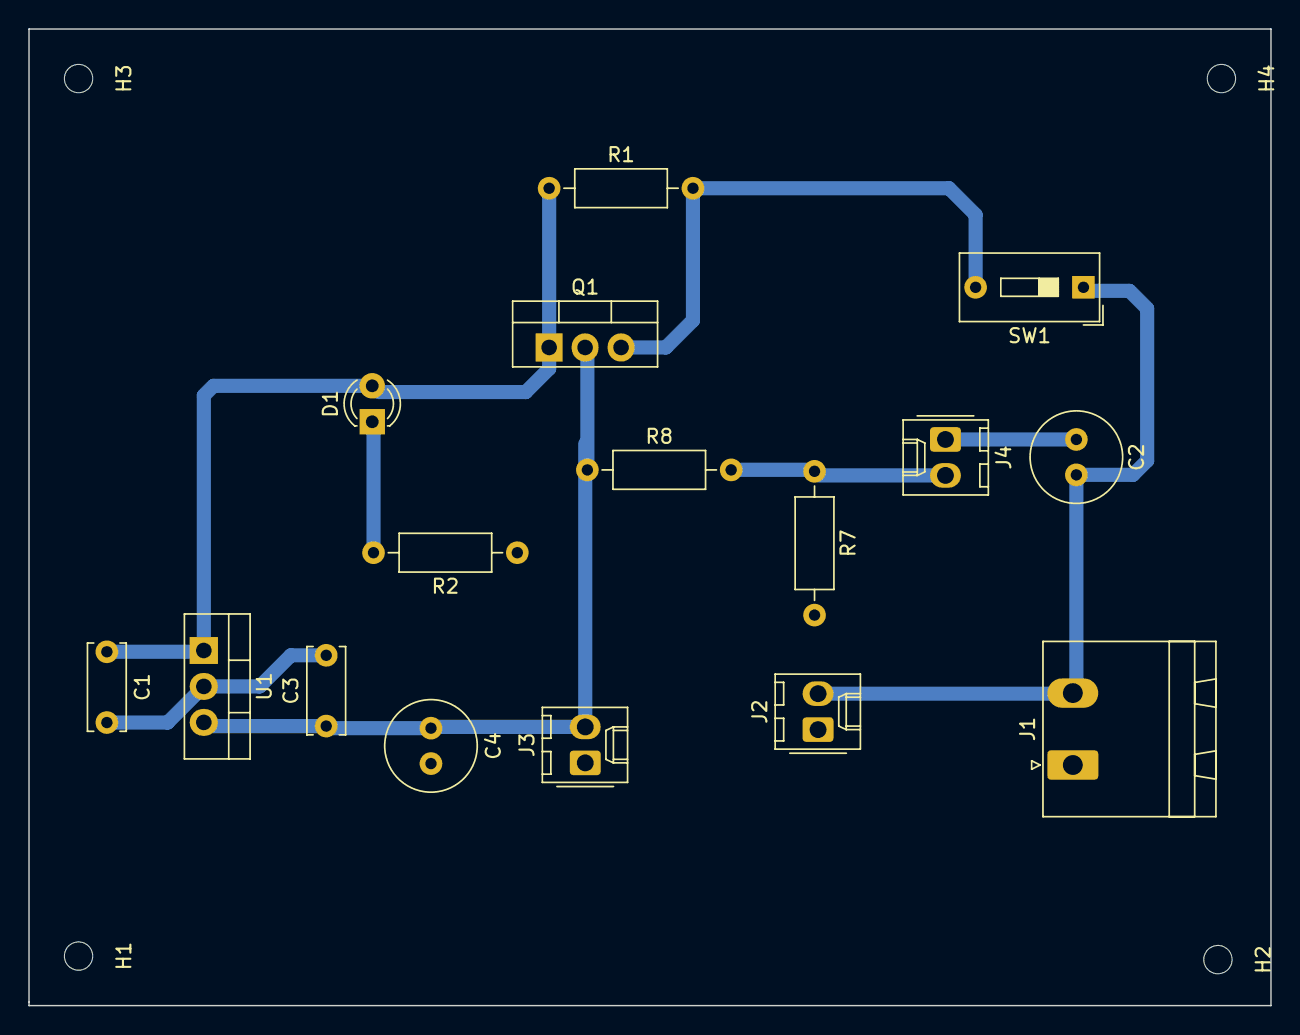
[picture p39: board Simetrica_v2.kicad_pcb from above]

Board: 2 copper layers, 87.8 x 69.0 mm, 20 parts (0 on the bottom side), 7 nets.
