Monitoramento-do-Ar-PI2/zefiro-electronics/AnalogElectronics/motor_coupler/motor_coupler.kicad_pcb

## KiCad design AnalogElectronics/motor_coupler/motor_coupler.kicad_pcb (2020-12-04)

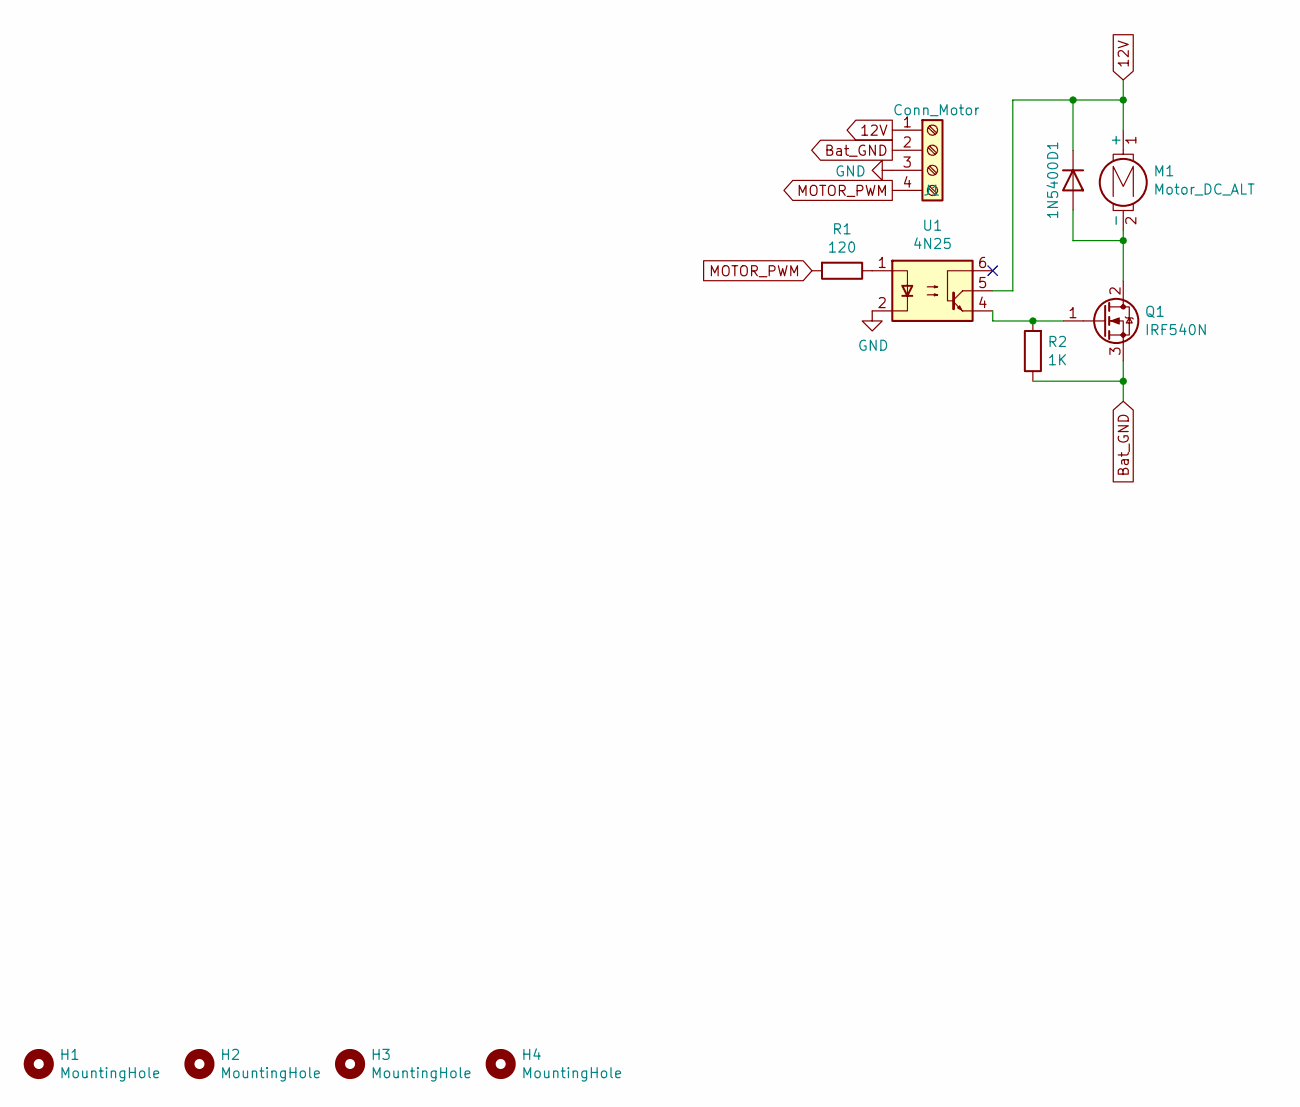
[picture p40: schematic motor_coupler.sch, Motor Couple]

Parts:
D1: 1N5400; D_DO-201AD_P15.24mm_Horizontal
H1, H2, H3, H4: MountingHole; MountingHole_3mm
J1: Conn_Motor; Molex_KK-254_AE-6410-04A_1x04_P2.54mm_Vertical
M1: Motor_DC_ALT; Molex_KK-254_AE-6410-02A_1x02_P2.54mm_Vertical
Q1: IRF540N; TO-220-3_Vertical
R1: 120; R_Axial_DIN0207_L6.3mm_D2.5mm_P10.16mm_Horizontal
R2: 1K; R_Axial_DIN0207_L6.3mm_D2.5mm_P10.16mm_Horizontal
U1: 4N25; DIP-6_W7.62mm

Connections:
12V: D1.1 (K), J1.1, M1.1 (+), U1.5
Bat_GND: J1.2, Q1.3 (S), R2.1
GND: J1.3, U1.2
MOTOR_PWM: J1.4, R1.2
unnamed: D1.2 (A), M1.2 (-), Q1.2 (D)
unnamed: Q1.1 (G), R2.2, U1.4
unnamed: R1.1, U1.1

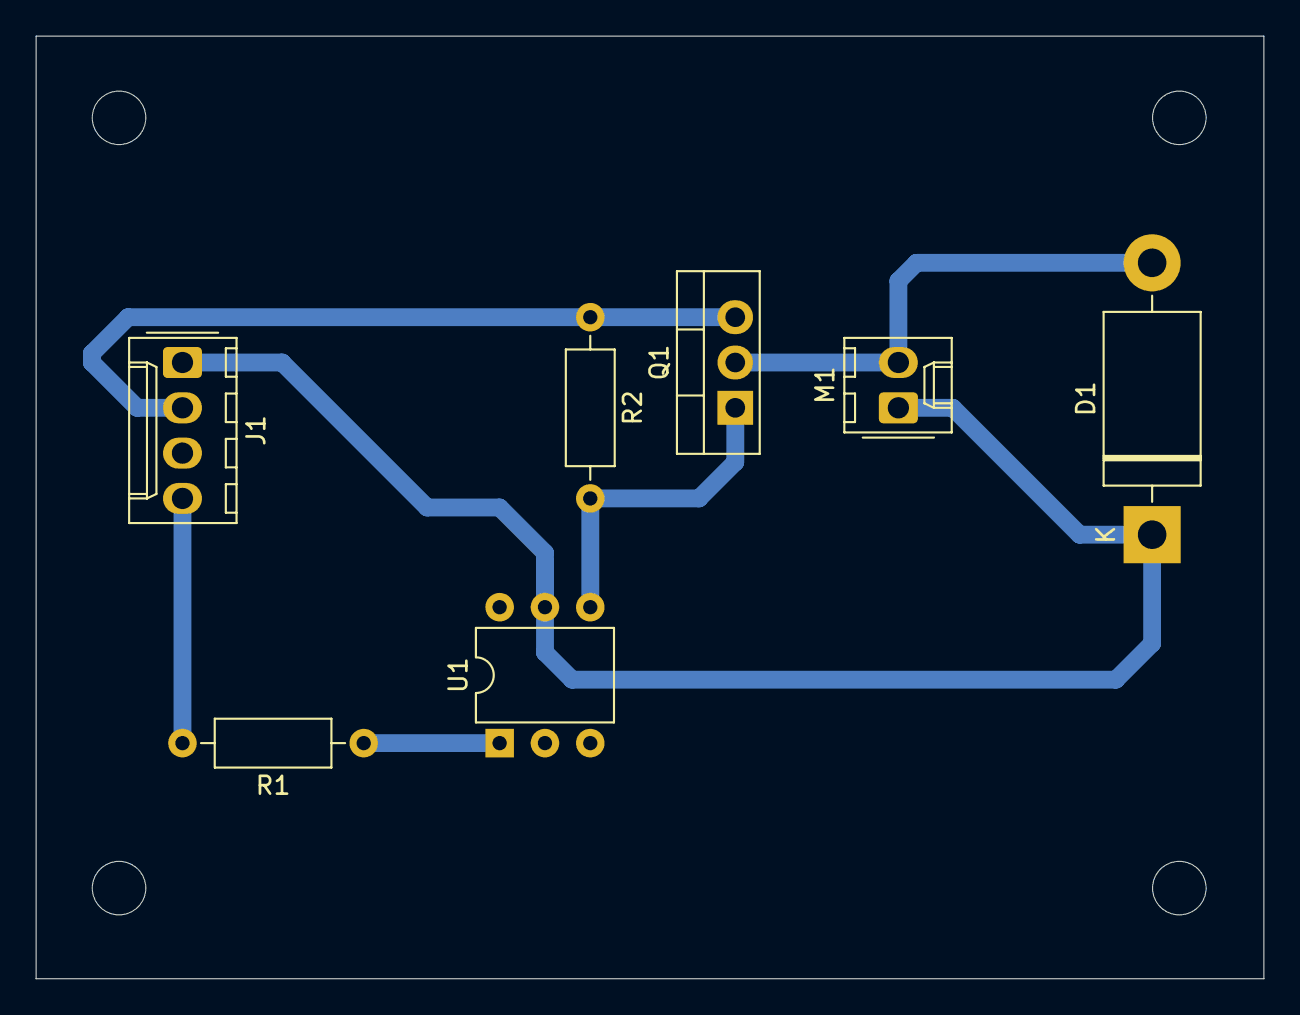
[picture p41: board motor_coupler.kicad_pcb from above]

Board: 2 copper layers, 68.8 x 52.8 mm, 11 parts (0 on the bottom side), 7 nets.
